Szczesnytendon/Bioreactor/LabVIEW code/Read me.docx

Please extract the zaber drivers into the folder before running the LabVIEW program.
