Szczesnytendon/Bioreactor/BOM Bioreactor.xlsx

Sheet: Basic BOM
 | Part | Company | Vendor (if different than company) | Serial number/model number/Link | Quanitity | Unit Price (Approximate) $ | Notes
Electrical
 | LVDT | TE connectivity | Digikey | HR 200 (https://www.digikey.com/en/products/detail/te-connectivity-measurement-specialties/02560391-000/3283570) | 4 | 192.8
 | LVDT conditioner | TE connectivity | Digikey | LVM 110 (https://www.digikey.com/en/products/detail/te-connectivity-measurement-specialties/04171776-000/373818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) | 4 | 223.4
 | AC to DC converter |  | Digikey | Link (https://www.digikey.com/en/products/detail/recom-power/RAC10-15DK-277/7807874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) | 1 | 10.8
 | Power cable |  | Digikey | Link (https://www.digikey.com/en/products/detail/qualtek/221002-01/245570) | 1 | 3.1
 | Load cell | Honeywell |  | Model 31, 10 lbs (https://sps.honeywell.com/us/en/products/sensing-and-iot/test-and-measurement-products/load-cells/miniature-load-cells/model-31-series) | 1 | 755
 | Load cell conditioner | Honeywell |  | Model GM Display Conditioner (https://sps.honeywell.com/us/en/products/sensing-and-iot/test-and-measurement-products/instrumentation/display-and-conditioning/gm-series) | 1 | 550
 | DAQ board | NI instruments |  | USB 6001 (https://www.ni.com/sic/configurator/configure.action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) | 1 | 220
 | Vertical Motor | Zaber |  | VSR40A-T3A (https://www.zaber.com/products/vertical-stages/VSR/details/VSR40A-T3A) | 1 | 1966
 | Motor Controller | Zaber |  | X-MCB1-KX13B (https://www.zaber.com/products/controllers-joysticks/X-MCB1/details/X-MCB1) | 1 | 720
Mechanical
 | T slot framing (20 mm) |  | McMaster Carr | 5537T101 (https://www.mcmaster.com/5537T101-5537T104/) | 6 | 8.28
 | T slot brackets |  | McMaster Carr | 5537T518 (https://www.mcmaster.com/5537T518/) | 16 | 5.04
 | 1 inch linear bearings | Tusk Direct |  | RX1-1SS | 4 | 210 | Call the company and ask for stainless steel interiors to prevent corrosion in humid environment of the incubator
 | 2 inch linear bearings | Tusk Direct |  | RX1-2SS | 4 | 229 | Call the company and ask for stainless steel interiors to prevent corrosion in humid environment of the incubator
 | Lube for bearings | Tusk Direct |  | LL-1 (https://www.tuskdirect.com/products/linear-lube.html) | 1 | 10
 | Pulleys |  | Amazon | PH0300SPL (https://www.amazon.com/gp/product/B00KZ0VYPU/ref=ppx_yo_dt_b_search_asin_title?ie=UTF8&psc=1) | 4 | 10.98
 | Hooks |  | McMaster Carr | 9491T11 (https://www.mcmaster.com/9491T11/) | 1 | 3.93
 | Fishing line |  | Amazon | Link (https://www.amazon.com/Stren-Fluorocast-Fluorocarbon-Fishing-Line/dp/B00NWD3LD0?th=1&psc=1) | 1 | 5.99
 | Weights |  | Amazon | PHZNW100SET (https://www.amazon.com/gp/product/B01LFTMBAG/ref=ppx_yo_dt_b_search_asin_title?ie=UTF8&psc=1) | 4 | 12.96
Fasteners
 | 1/4-20 socket screws (1-1/4"") |  | McMaster Carr | 92185A544 (https://www.mcmaster.com/92185A544/) | 1 | 3.75
 | 8-32 socket screws (7/8") |  | McMaster Carr | 92185A198 (https://www.mcmaster.com/92185A198/) | 1 | 8.61
 | 6- 32 threaded rod (3/4") |  | McMaster Carr | 90575A162 (https://www.mcmaster.com/90575A162/) | 1 | 9.18
 | 6- 32 threaded rod (1-1/2") |  | McMaster Carr | 90575A164 (https://www.mcmaster.com/90575A164/) | 1 | 6.81
 | 6-32 nuts |  | McMaster Carr | 90730A007 (https://www.mcmaster.com/90730A007/) | 1 | 4.04
 | 6-32 socket screws (3/4") |  | McMaster Carr | 92185A151 (https://www.mcmaster.com/92185A151/) | 1 | 2.95
 | 2-56 socket screws (7/16") |  | McMaster Carr | 92185A081 (https://www.mcmaster.com/92185A081/) | 1 | 4.02
 | 2-56 socket screws (9/16") |  | McMaster Carr | 92185A086 (https://www.mcmaster.com/92185A086/) | 1 | 4.46
 | 2-56 socket screws (5/16") |  | McMaster Carr | 92185A078 (https://www.mcmaster.com/92185A078/) | 1 | 3.84
 | 2-56 socket screws (1- 3/8") |  | McMaster Carr | 92196A090 (https://www.mcmaster.com/92196A090/) | 1 | 11.12
Miscelleaneous
 | V cutter |  | McMaster Carr | 29755A17 (https://www.mcmaster.com/29755A17/) | 1 | 51.55 | If not available in the machining shop
 | Sandpaper |  | McMaster Carr | 4671A32 (https://www.mcmaster.com/catalog/127/2848) | As required | 18.49
 | 4 Well plates |  | Thermo Fisher | 267061 (https://www.thermofisher.com/order/catalog/product/267060?SID=srch-srp-267060) | As required | 484

Sheet: Minimum costs + materials
Part |  |  | Link | Qty | Unit Cost | Total cost
Vertical Motor | Zaber |  | VSR40A-T3A (https://www.zaber.com/products/vertical-stages/VSR/details/VSR40A-T3A) | 1 | 1966 | 1966
Motor Controller | Zaber |  | X-MCB1-KX13B (https://www.zaber.com/products/controllers-joysticks/X-MCB1/details/X-MCB1) | 1 | 720 | 720
1 inch linear bearings | Tusk Direct |  | RX1-1SS | 4 | 210 | 840
2 inch linear bearings | Tusk Direct |  | RX1-2SS | 4 | 229 | 916
Pulleys |  | Amazon | PH0300SPL (https://www.amazon.com/gp/product/B00KZ0VYPU/ref=ppx_yo_dt_b_search_asin_title?ie=UTF8&psc=1) | 4 | 10.98 | 43.92
T slot framing (20 mm) |  | McMaster Carr | 5537T101 (https://www.mcmaster.com/5537T101-5537T104/) | 6 | 8.28 | 49.68
T slot brackets |  | McMaster Carr | 5537T518 (https://www.mcmaster.com/5537T518/) | 16 | 5.04 | 80.64
Polycarbonate (Base plate) |  | McMaster Carr | 84805K32 (https://www.mcmaster.com/84805K32) | 1 | 209.85 | 209.85
Aluminum (Back plate) |  | McMaster Carr | 8975K215 (https://www.mcmaster.com/8975K215) | 1 | 22.95 | 22.95
Grip and grip holders |  |  | 9083K46 (https://www.mcmaster.com/9083K46) | 1 | 117.81 | 117.81
Load cell placeholder |  |  | 8974K28 (https://www.mcmaster.com/8974K28) | 1 | 1.97 | 1.97
Polycarbonate (blocks under grips) |  |  | 1749K549 (https://www.mcmaster.com/1749K549) | 1 | 20.38 | 20.38
Pulley base |  |  | 9008K46 (https://www.mcmaster.com/9008K46) | 1 | 20.98 | 20.98
 |  |  |  |  |  | 5010.18

Sheet: Our costs
Machining costs |  |  |  |  |  | 4275
Vertical Motor | Zaber |  | VSR40A-T3A (https://www.zaber.com/products/vertical-stages/VSR/details/VSR40A-T3A) | 1 | 1966 | 1966
Motor Controller | Zaber |  | X-MCB1-KX13B (https://www.zaber.com/products/controllers-joysticks/X-MCB1/details/X-MCB1) | 1 | 720 | 720
1 inch linear bearings | Tusk Direct |  | RX1-1SS | 4 | 210 | 840
2 inch linear bearings | Tusk Direct |  | RX1-2SS | 4 | 229 | 916
Pulleys |  | Amazon | PH0300SPL (https://www.amazon.com/gp/product/B00KZ0VYPU/ref=ppx_yo_dt_b_search_asin_title?ie=UTF8&psc=1) | 4 | 10.98 | 43.92
T slot framing (20 mm) |  | McMaster Carr | 5537T101 (https://www.mcmaster.com/5537T101-5537T104/) | 6 | 8.28 | 49.68
T slot brackets |  | McMaster Carr | 5537T518 (https://www.mcmaster.com/5537T518/) | 16 | 5.04 | 80.64
LVDT | TE connectivity | Digikey | HR 200 (https://www.digikey.com/en/products/detail/te-connectivity-measurement-specialties/02560391-000/3283570) | 4 | 192.8 | 771.2
LVDT conditioner | TE connectivity | Digikey | LVM 110 (https://www.digikey.com/en/products/detail/te-connectivity-measurement-specialties/04171776-000/373818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) | 4 | 223.4 | 893.6
AC to DC converter |  | Digikey | Link (https://www.digikey.com/en/products/detail/recom-power/RAC10-15DK-277/7807874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) | 1 | 10.8 | 10.8
Power cable |  | Digikey | Link (https://www.digikey.com/en/products/detail/qualtek/221002-01/245570) | 1 | 3.1 | 3.1
Load cell | Honeywell |  | Model 31, 10 lbs (https://sps.honeywell.com/us/en/products/sensing-and-iot/test-and-measurement-products/load-cells/miniature-load-cells/model-31-series) | 1 | 755 | 755
Load cell conditioner | Honeywell |  | Model GM Display Conditioner (https://sps.honeywell.com/us/en/products/sensing-and-iot/test-and-measurement-products/instrumentation/display-and-conditioning/gm-series) | 1 | 550 | 550
DAQ board | NI instruments |  | USB 6001 (https://www.ni.com/sic/configurator/configure.action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) | 1 | 220 | 220
 |  |  |  |  |  | 12094.94
