Szczesnytendon/Bioreactor/Bioreactor design/Grips/Flat Grip Assem.SLDASM

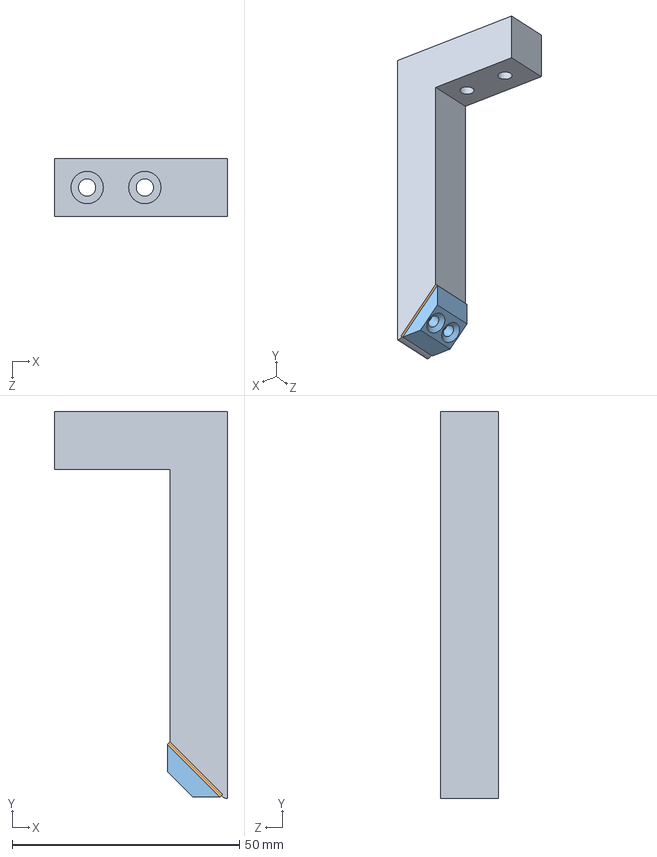
[picture p1: CAD file, 2021-02-22]
Bioreactor design/Grips/Flat Grip Assem.SLDASM
38.1 x 85.1 x 12.7 mm
Flat Grip
Spacer x 2
Flat Grip Clamp
