Szczesnytendon/Bioreactor/Bioreactor design/Motor subassembly.SLDASM

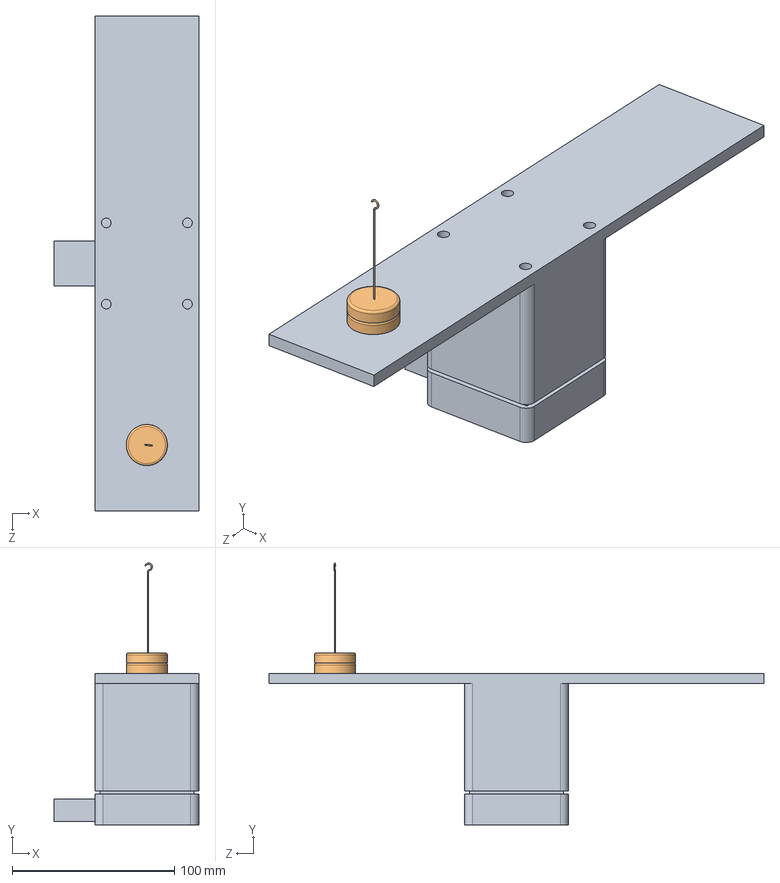
[picture p2: CAD file, 2021-02-22]
Bioreactor design/Motor subassembly.SLDASM
89.1 x 161.3 x 304.8 mm
Motor
Weights
