Szczesnytendon/Bioreactor/Bioreactor design/Fixed grip subassembly.SLDASM

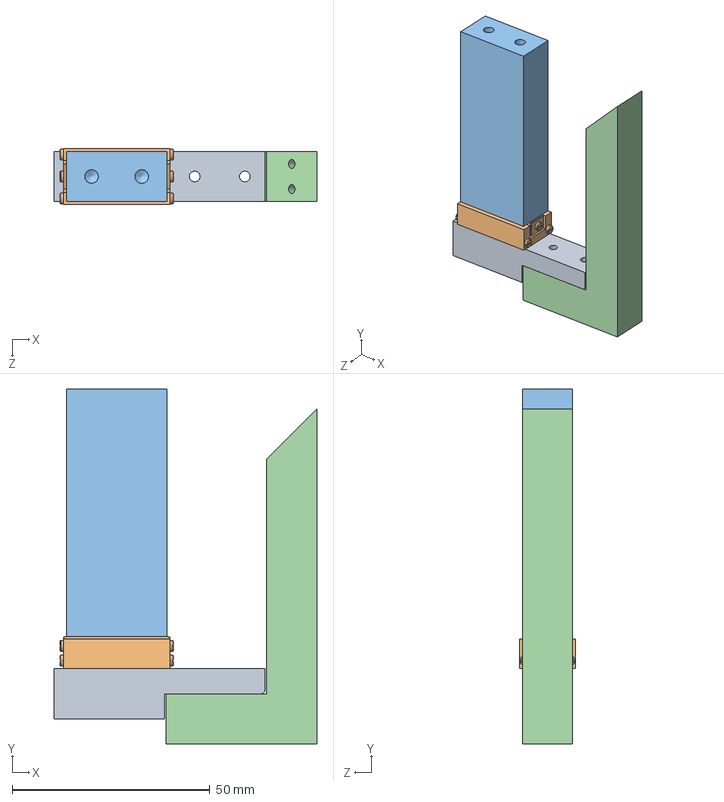
[picture p3: CAD file, 2021-02-22]
Bioreactor design/Fixed grip subassembly.SLDASM
66.5 x 89.8 x 14.2 mm
Fixed Grip holder
Fixed Linear bearing
Plastic block under the fixed grip
Stainless steel grip
