Szczesnytendon/Bioreactor/Bioreactor design/Bioreactor Assembly.SLDASM

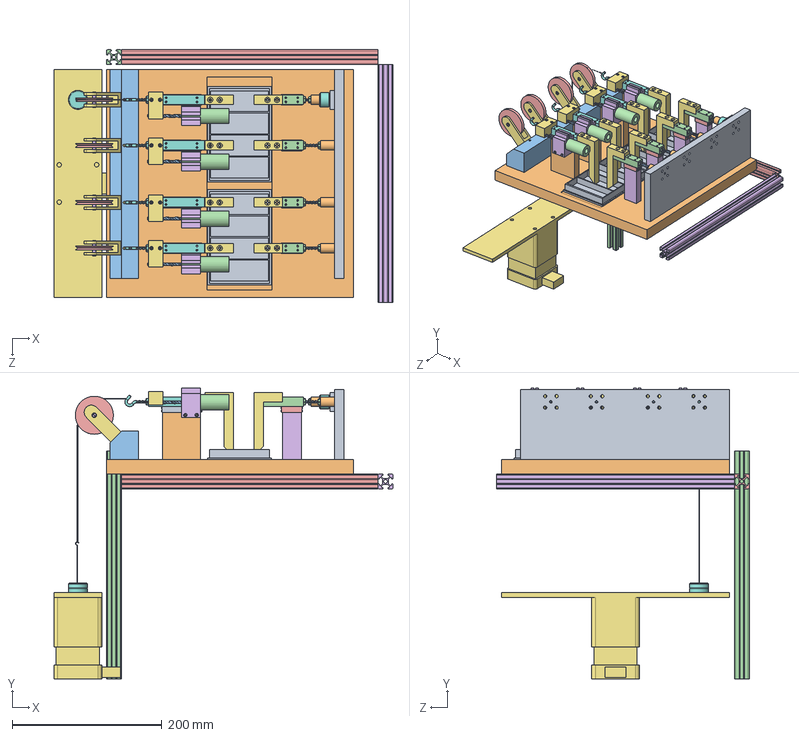
[picture p4: CAD file, 2021-02-22]
Bioreactor design/Bioreactor Assembly.SLDASM
453.0 x 388.8 x 337.5 mm
Back plate
Base plate
Pulley base
Fixed Grip holder x 4
Fixed Linear bearing x 4
Plastic block under the fixed grip x 4
Stainless steel grip x 8
Movable grip holder x 4
Movable linear bearing x 4
Plastic block under the movable grip x 4
Core connecting rod x 4
LVDT body x 4
LVDT core x 4
LVDT mount x 4
Core mount x 4
Hook x 4
Well plate x 2
Load cell substitute x 3
6-32 Threaded rod 1.5in x 3
6-32 Nut x 8
Pulley x 4
Pulley screws x 8
Pulley support plastic x 4
Load cell
Load cell plate
Load cell thread adapter
6-32 threaded rod 0.75inch
Motor
Weights
rope try
