Szczesnytendon/Bioreactor/Bioreactor design/Load cell substitute subassembly.SLDASM

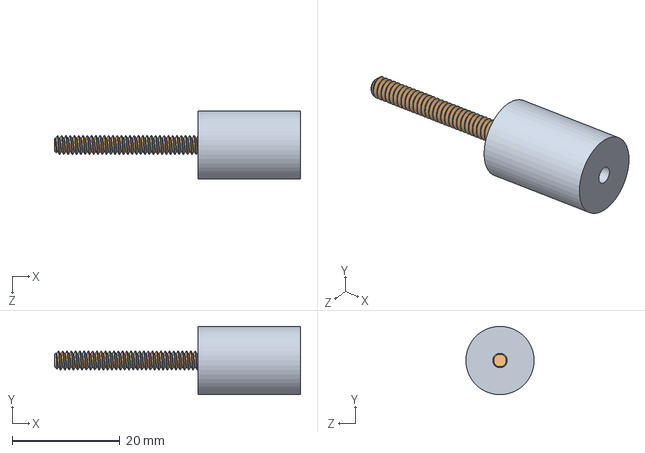
[picture p5: CAD file, 2021-02-22]
Bioreactor design/Load cell substitute subassembly.SLDASM
45.7 x 12.7 x 12.7 mm
Load cell substitute
6-32 Threaded rod 1.5in
