Szczesnytendon/Bioreactor/Bioreactor design/Stand subassembly.SLDASM

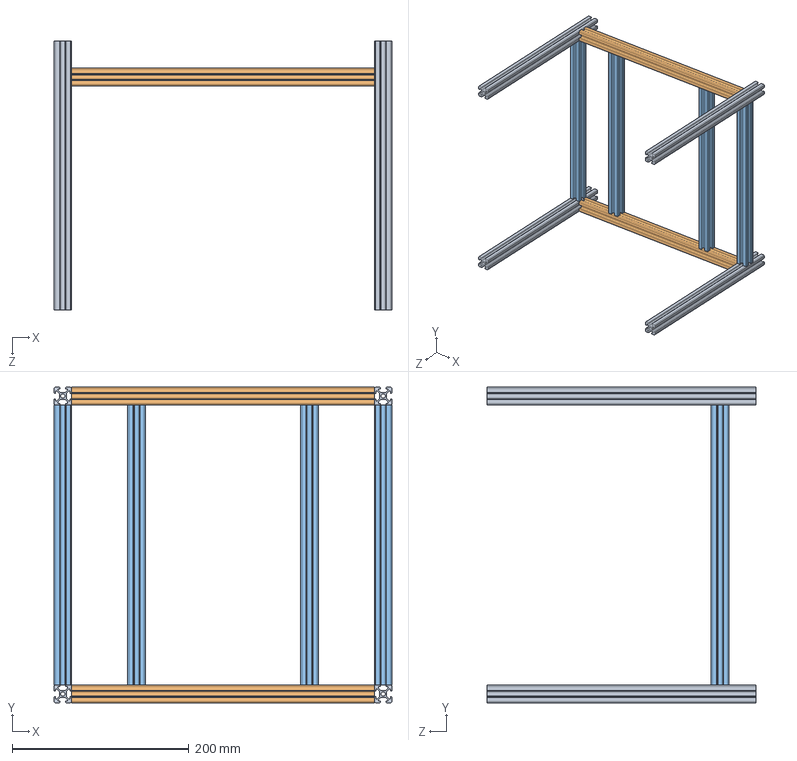
[picture p6: CAD file, 2021-02-22]
Bioreactor design/Stand subassembly.SLDASM
382.9 x 357.5 x 304.8 mm
Aluminum 20mm t slot 12 in vertical x 4
Aluminum 20mm t slot 13.5in x 2
Aluminum 20mm t slot 12.5in x 4
