Szczesnytendon/Bioreactor/Bioreactor design/Pulley subassembly.SLDASM

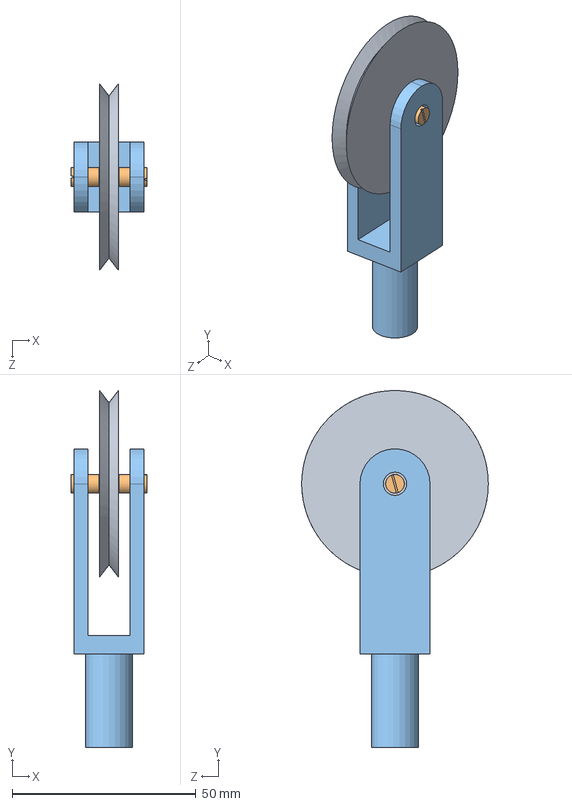
[picture p7: CAD file, 2021-02-22]
Bioreactor design/Pulley subassembly.SLDASM
20.6 x 97.1 x 50.8 mm
Pulley
Pulley screws x 2
Pulley support plastic
