Szczesnytendon/Bioreactor/Bioreactor design/Load cell subassembly.SLDASM

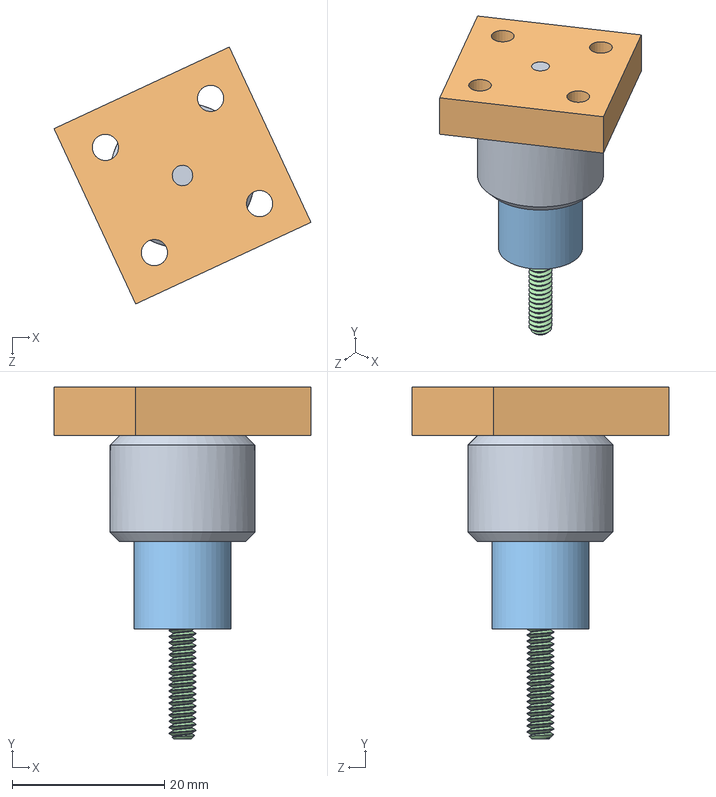
[picture p8: CAD file, 2021-02-22]
Bioreactor design/Load cell subassembly.SLDASM
33.8 x 46.2 x 33.8 mm
Load cell
Load cell plate
Load cell thread adapter
6-32 threaded rod 0.75inch
