Szczesnytendon/Bioreactor/Bioreactor design/Core connecting rod.SLDPRT

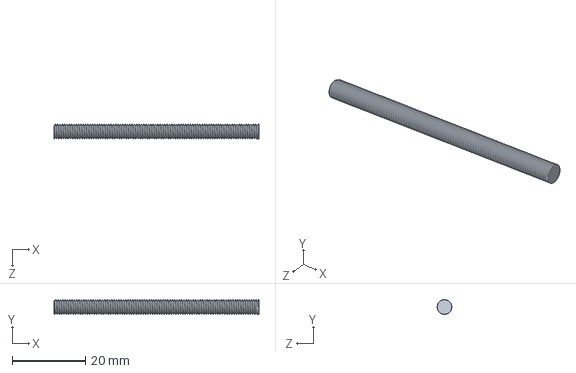
[picture p9: CAD file, 2021-02-22]
Bioreactor design/Core connecting rod.SLDPRT
55.9 x 4.00 x 4.00 mm
