Szczesnytendon/Bioreactor/Bioreactor design/Grips/Serrated grip left.SLDPRT

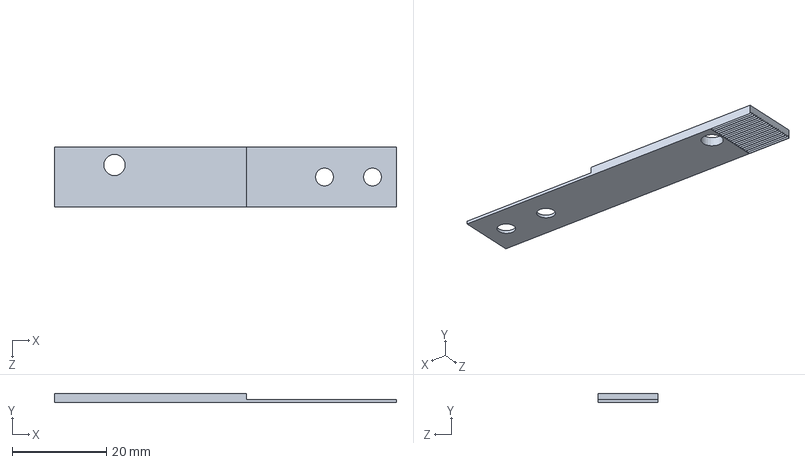
[picture p10: CAD file, 2021-02-22]
Bioreactor design/Grips/Serrated grip left.SLDPRT
72.4 x 1.90 x 12.7 mm
