Szczesnytendon/Bioreactor/Bioreactor design/Stainless steel grip.SLDPRT

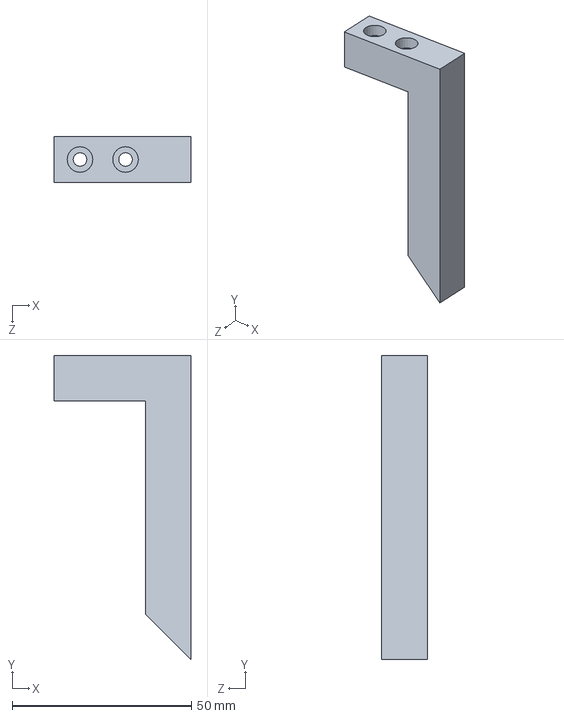
[picture p11: CAD file, 2021-02-22]
Bioreactor design/Stainless steel grip.SLDPRT
38.1 x 84.8 x 12.7 mm
