Szczesnytendon/Bioreactor/Bioreactor design/Core mount.SLDPRT

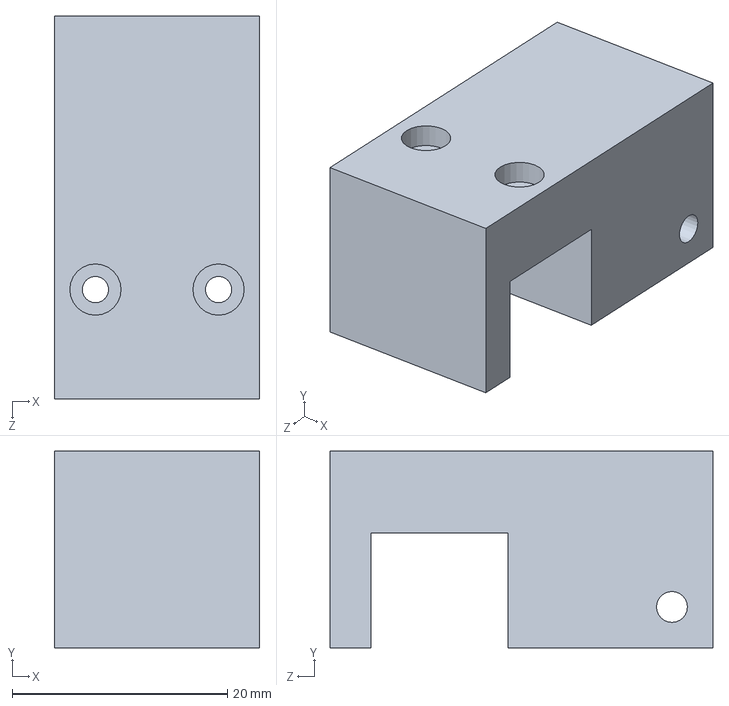
[picture p12: CAD file, 2021-02-22]
Bioreactor design/Core mount.SLDPRT
19.1 x 18.3 x 35.6 mm
