Szczesnytendon/Bioreactor/Bioreactor design/Grips/Spacer.SLDPRT

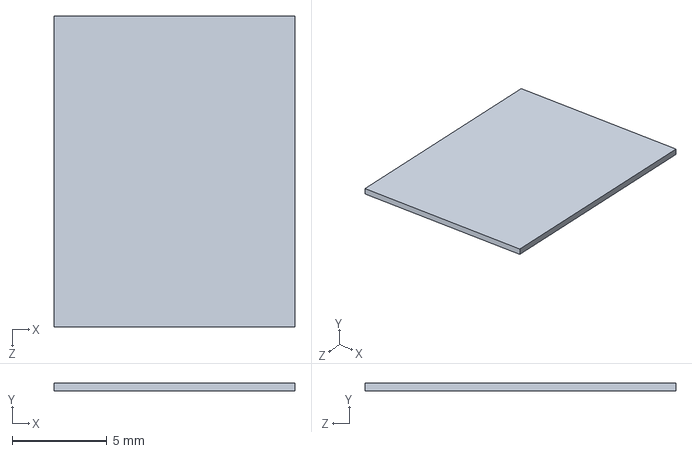
[picture p13: CAD file, 2021-02-22]
Bioreactor design/Grips/Spacer.SLDPRT
12.7 x 0.4 x 16.4 mm
