Szczesnytendon/Bioreactor/Bioreactor design/Fixed Linear bearing.SLDPRT

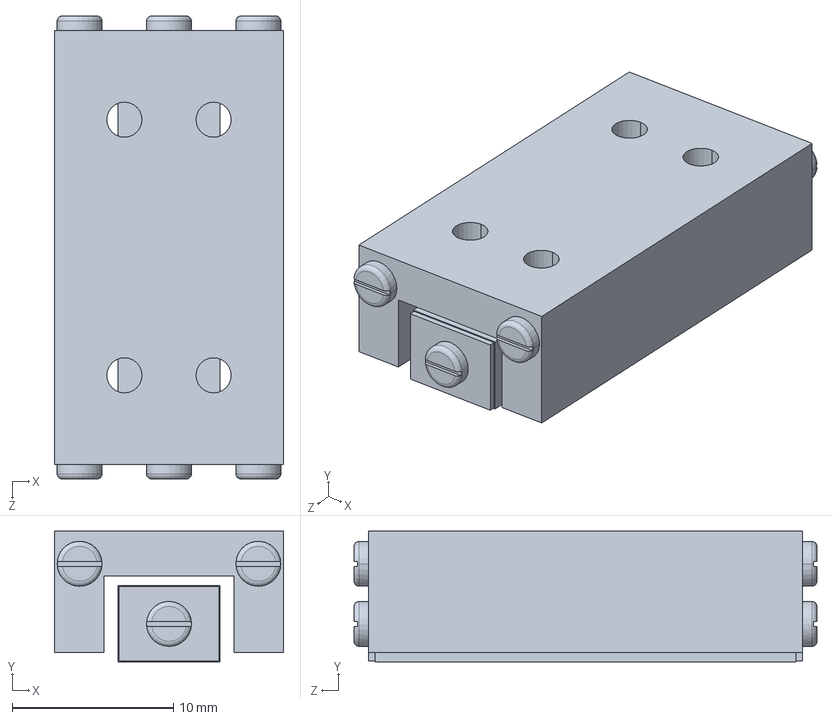
[picture p14: CAD file, 2021-02-22]
Bioreactor design/Fixed Linear bearing.SLDPRT
14.2 x 8.13 x 28.8 mm
