Szczesnytendon/Bioreactor/Bioreactor design/Grips/Serrated grip holder.SLDPRT

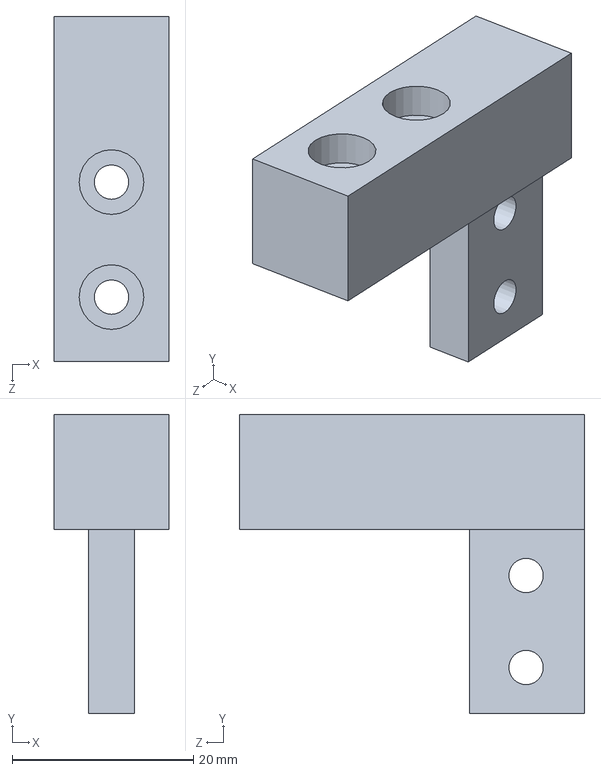
[picture p15: CAD file, 2021-02-22]
Bioreactor design/Grips/Serrated grip holder.SLDPRT
12.7 x 33.0 x 38.1 mm
