Szczesnytendon/Bioreactor/Bioreactor design/Motor.SLDPRT

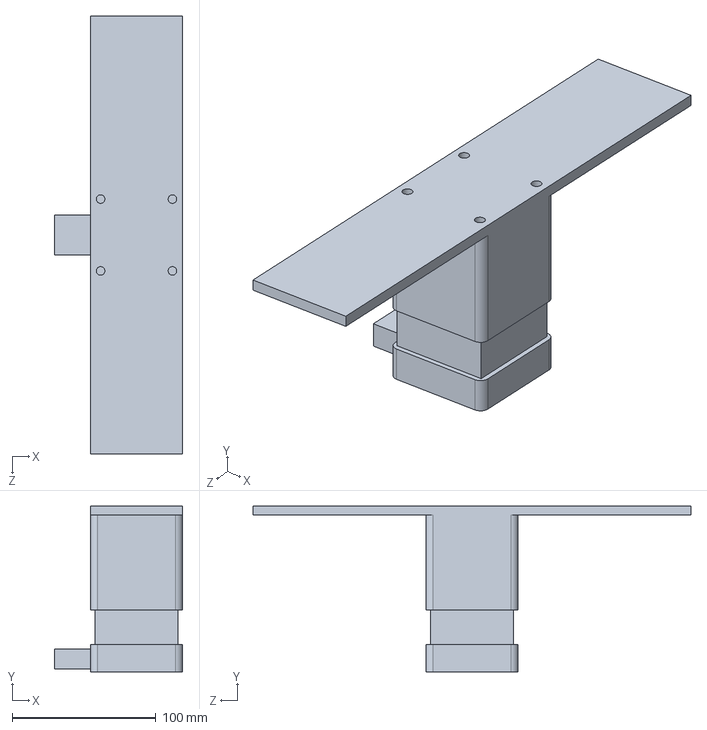
[picture p16: CAD file, 2021-02-22]
Bioreactor design/Motor.SLDPRT
89.1 x 115.3 x 304.8 mm
