Szczesnytendon/Bioreactor/Bioreactor design/Fixed Grip holder.SLDPRT

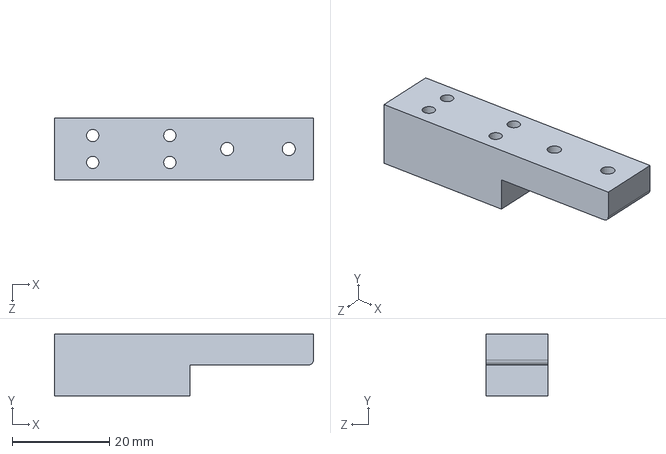
[picture p17: CAD file, 2021-02-22]
Bioreactor design/Fixed Grip holder.SLDPRT
53.3 x 12.7 x 12.7 mm
