Szczesnytendon/Bioreactor/Bioreactor design/Grips/Flat Grip Clamp.SLDPRT

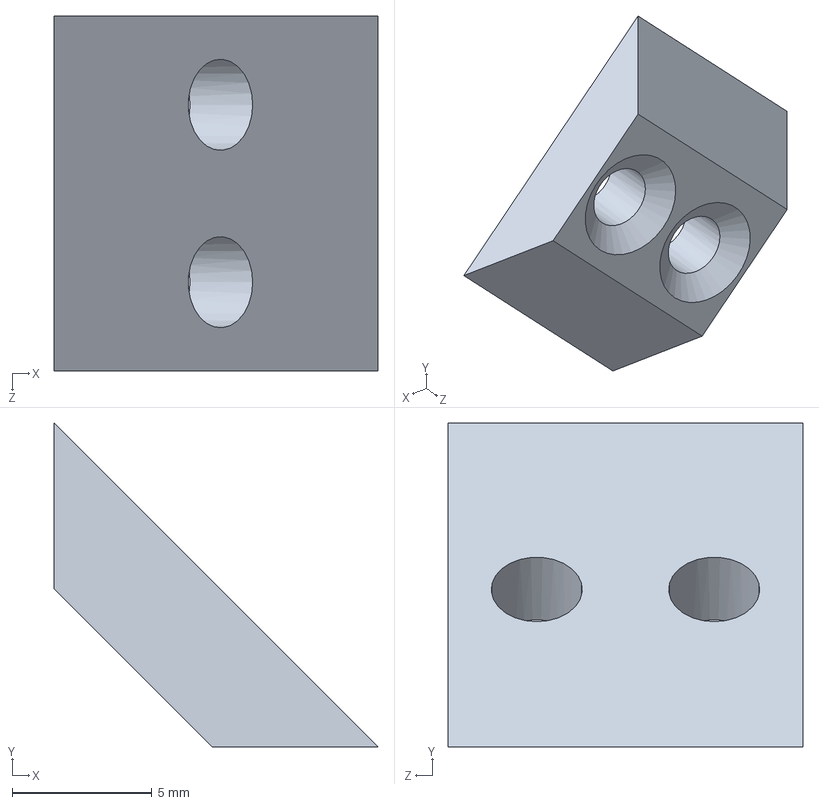
[picture p18: CAD file, 2021-02-22]
Bioreactor design/Grips/Flat Grip Clamp.SLDPRT
11.6 x 11.6 x 12.7 mm
