Szczesnytendon/Bioreactor/Bioreactor design/Movable linear bearing.SLDPRT

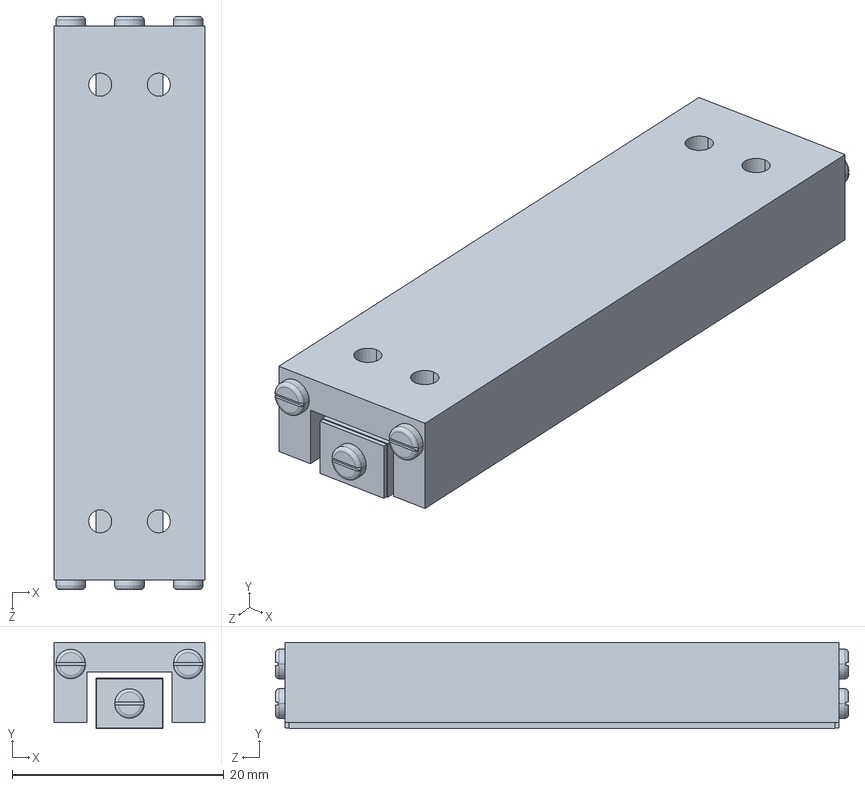
[picture p19: CAD file, 2021-02-22]
Bioreactor design/Movable linear bearing.SLDPRT
14.2 x 8.13 x 54.2 mm
