Szczesnytendon/Bioreactor/Bioreactor design/Pulley base.SLDPRT

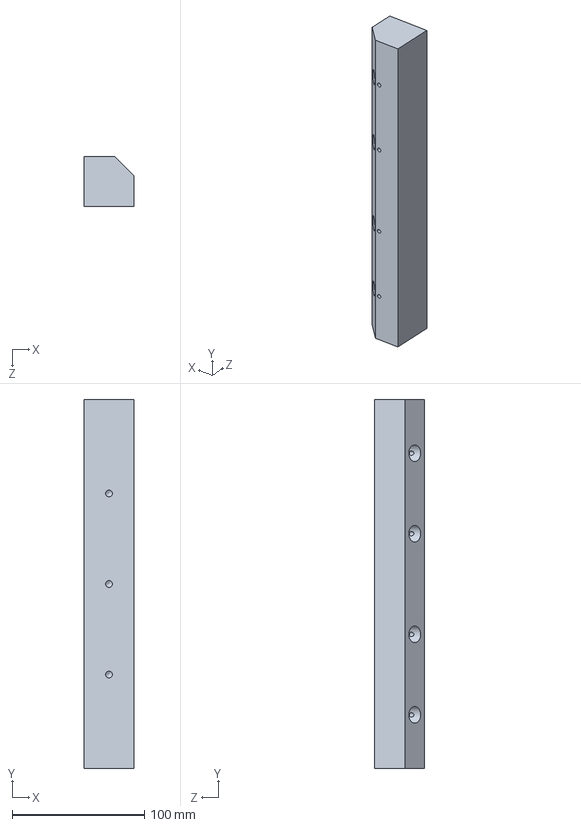
[picture p20: CAD file, 2021-02-22]
Bioreactor design/Pulley base.SLDPRT
38.1 x 279.4 x 38.1 mm
