Szczesnytendon/Bioreactor/Bioreactor design/Aluminum 20mm t slot 13.5in.SLDPRT

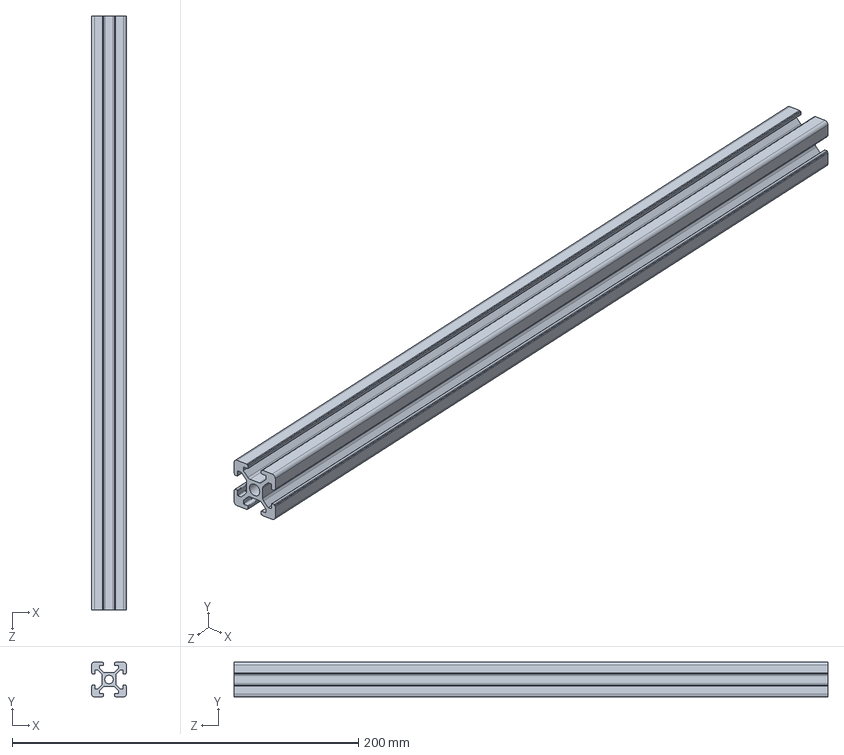
[picture p21: CAD file, 2021-02-22]
Bioreactor design/Aluminum 20mm t slot 13.5in.SLDPRT
20.0 x 20.0 x 342.9 mm
