Szczesnytendon/Bioreactor/Bioreactor design/Weights.SLDPRT

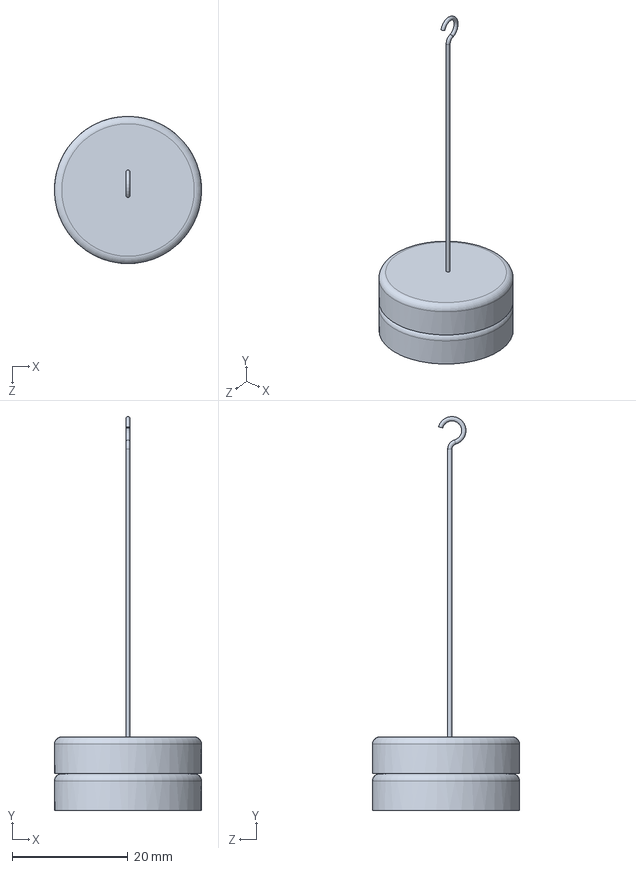
[picture p22: CAD file, 2021-02-22]
Bioreactor design/Weights.SLDPRT
25.4 x 68.0 x 25.4 mm
