Szczesnytendon/Bioreactor/Bioreactor design/Load cell substitute.SLDPRT

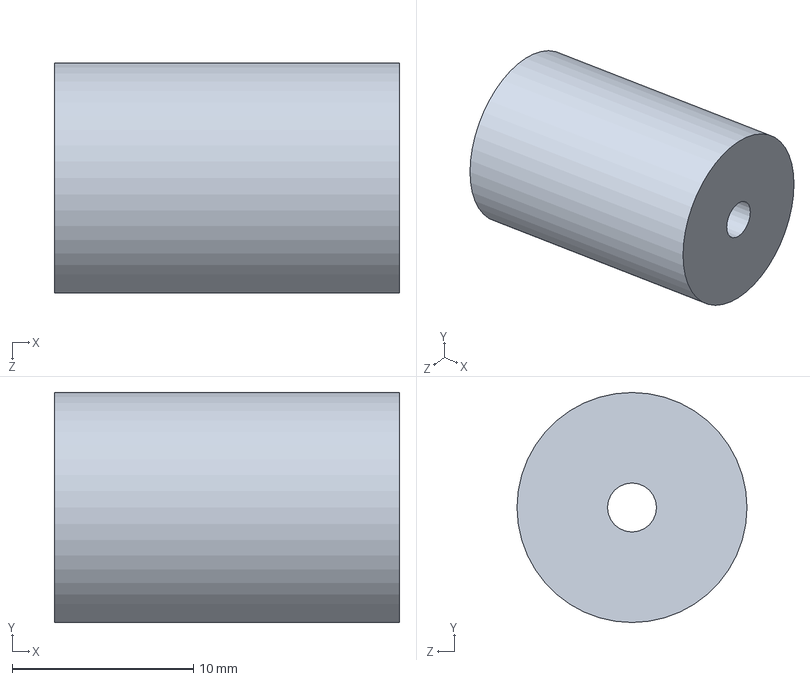
[picture p23: CAD file, 2021-02-22]
Bioreactor design/Load cell substitute.SLDPRT
19.1 x 12.7 x 12.7 mm
