Szczesnytendon/Bioreactor/Bioreactor design/Base plate.SLDPRT

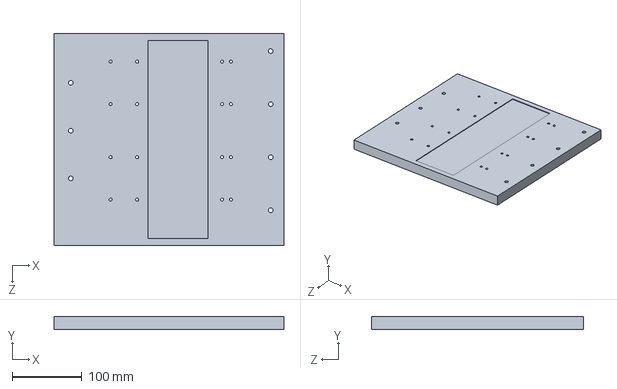
[picture p24: CAD file, 2021-02-22]
Bioreactor design/Base plate.SLDPRT
330.2 x 19.1 x 304.8 mm
