Szczesnytendon/Bioreactor/Bioreactor design/Plastic block under the movable grip.SLDPRT

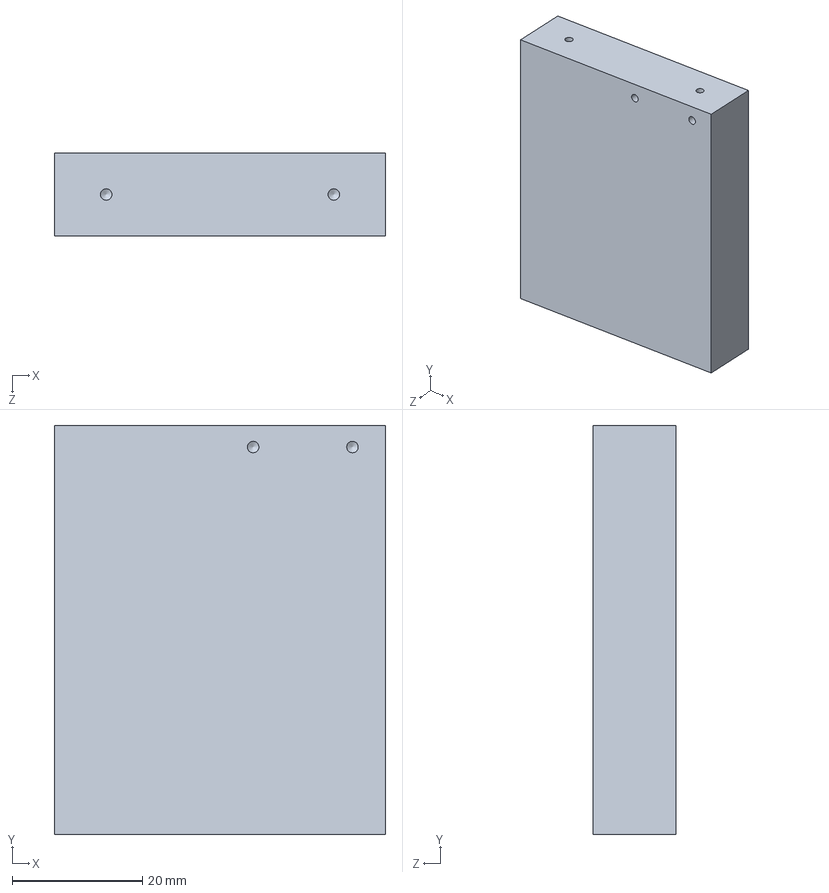
[picture p25: CAD file, 2021-02-22]
Bioreactor design/Plastic block under the movable grip.SLDPRT
50.8 x 62.7 x 12.7 mm
