Szczesnytendon/Bioreactor/Bioreactor design/LVDT core.SLDPRT

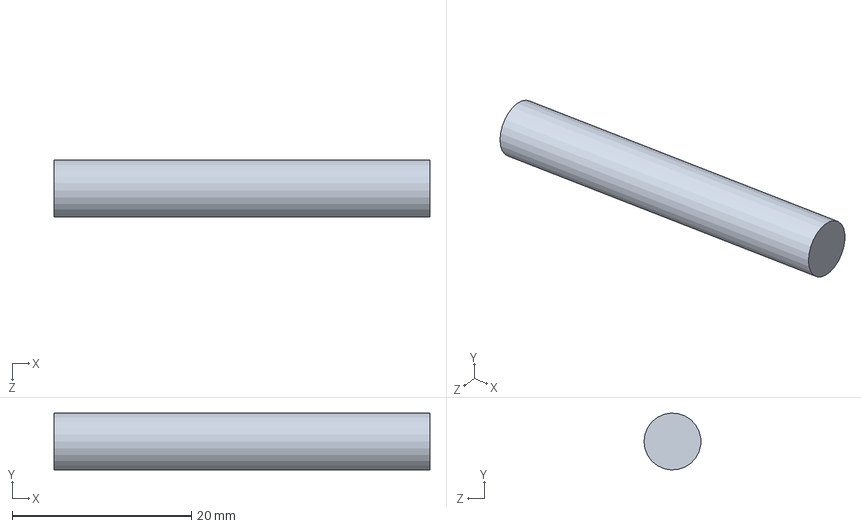
[picture p26: CAD file, 2021-02-22]
Bioreactor design/LVDT core.SLDPRT
41.9 x 6.34 x 6.35 mm
