Szczesnytendon/Bioreactor/Bioreactor design/Load cell plate.SLDPRT

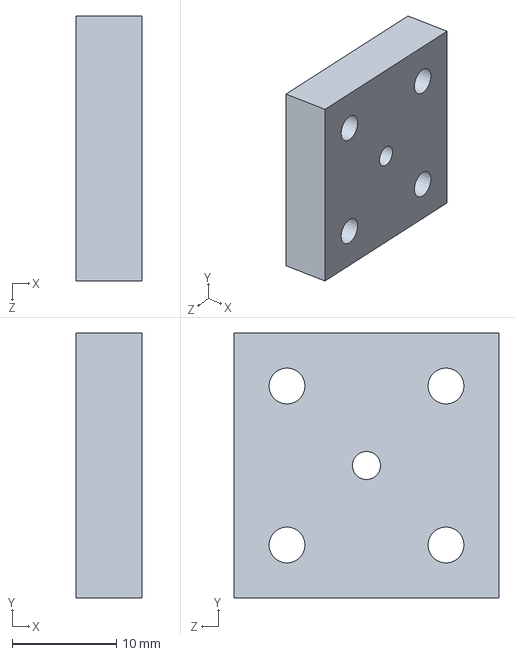
[picture p27: CAD file, 2021-02-22]
Bioreactor design/Load cell plate.SLDPRT
6.35 x 25.4 x 25.4 mm
