Szczesnytendon/Bioreactor/Bioreactor design/Aluminum 20mm t slot 12 in vertical.SLDPRT

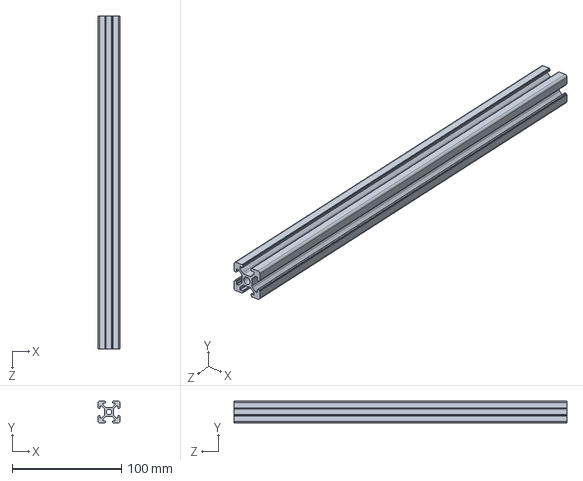
[picture p28: CAD file, 2021-02-22]
Bioreactor design/Aluminum 20mm t slot 12 in vertical.SLDPRT
20.0 x 20.0 x 304.8 mm
