Szczesnytendon/Bioreactor/Bioreactor design/6-32 Threaded rod 1.5in.SLDPRT

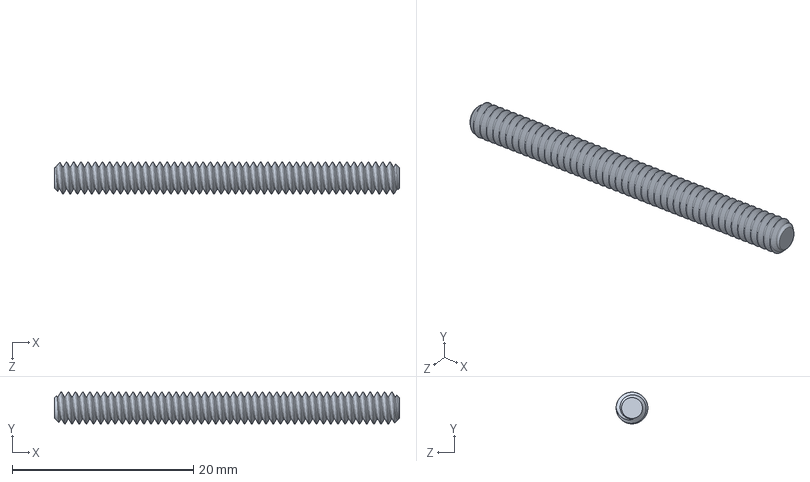
[picture p29: CAD file, 2021-02-22]
Bioreactor design/6-32 Threaded rod 1.5in.SLDPRT
38.1 x 3.51 x 3.51 mm
