Szczesnytendon/Bioreactor/Bioreactor design/Right threaded stud.SLDPRT

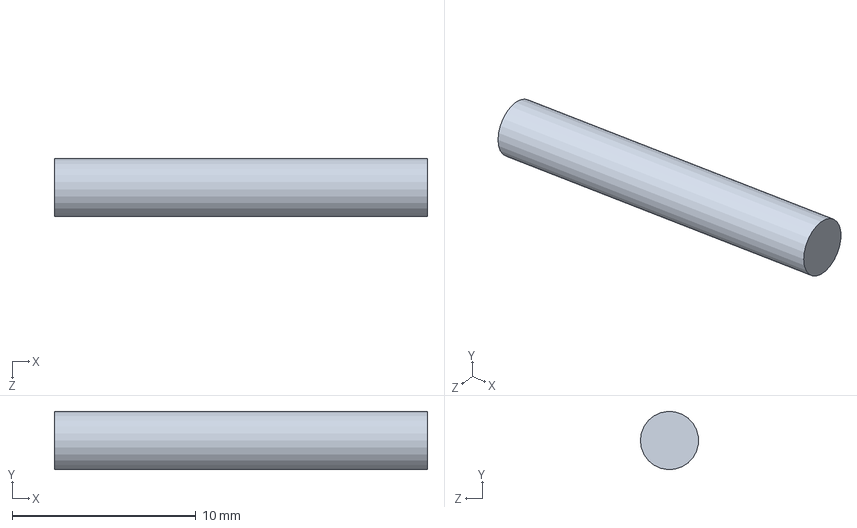
[picture p30: CAD file, 2021-02-22]
Bioreactor design/Right threaded stud.SLDPRT
20.3 x 3.17 x 3.17 mm
