Szczesnytendon/Bioreactor/Bioreactor design/LVDT mount.SLDPRT

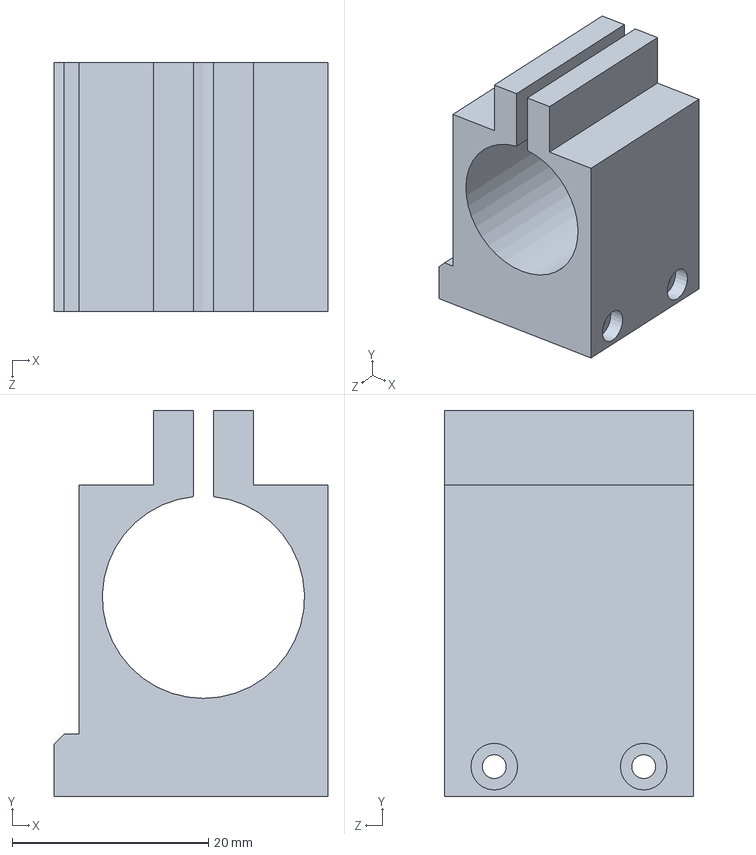
[picture p31: CAD file, 2021-02-22]
Bioreactor design/LVDT mount.SLDPRT
27.9 x 39.4 x 25.4 mm
