Szczesnytendon/Bioreactor/Bioreactor design/Load cell.SLDPRT

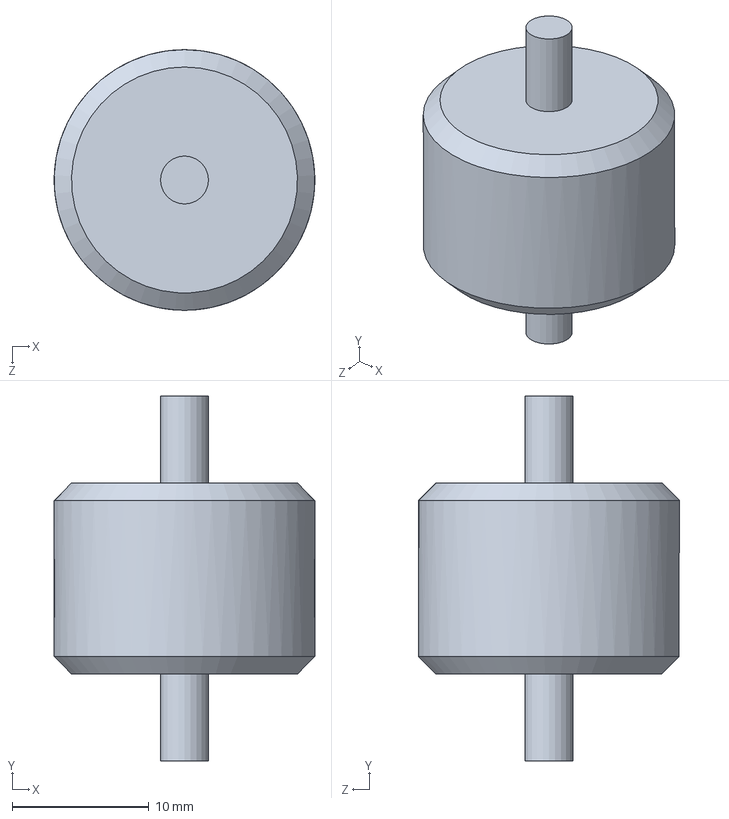
[picture p32: CAD file, 2021-02-22]
Bioreactor design/Load cell.SLDPRT
19.0 x 26.7 x 19.1 mm
