Szczesnytendon/Bioreactor/Bioreactor design/Back plate.SLDPRT

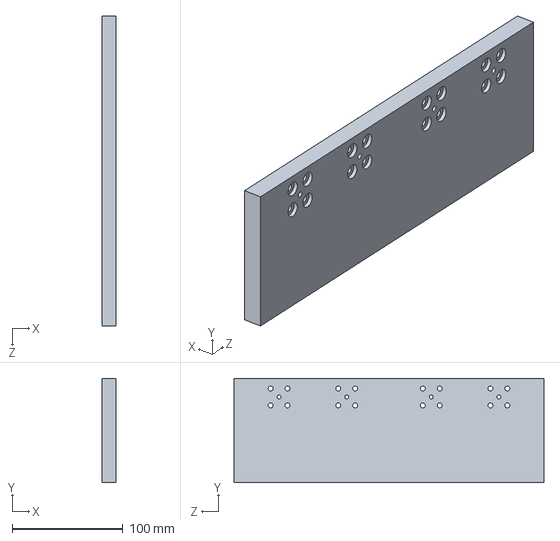
[picture p33: CAD file, 2021-02-22]
Bioreactor design/Back plate.SLDPRT
12.7 x 94.0 x 279.4 mm
