Szczesnytendon/Bioreactor/Bioreactor design/Aluminum 20mm t slot.SLDPRT

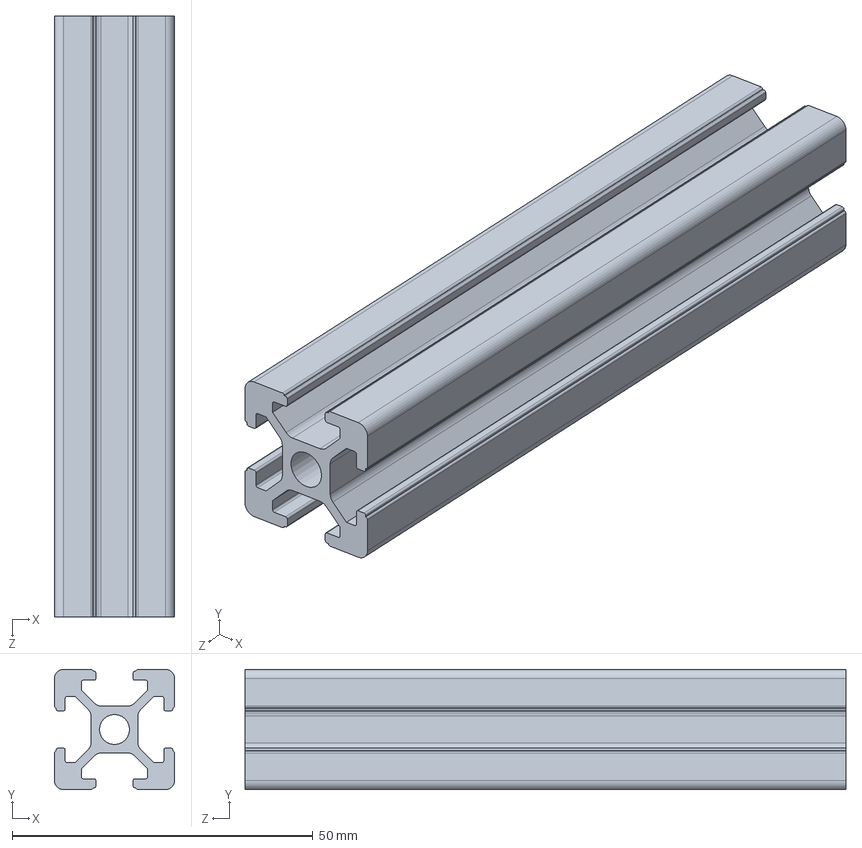
[picture p34: CAD file, 2021-02-22]
Bioreactor design/Aluminum 20mm t slot.SLDPRT
20.0 x 20.0 x 100.0 mm
