Szczesnytendon/Bioreactor/Bioreactor design/Pulley support plastic.SLDPRT

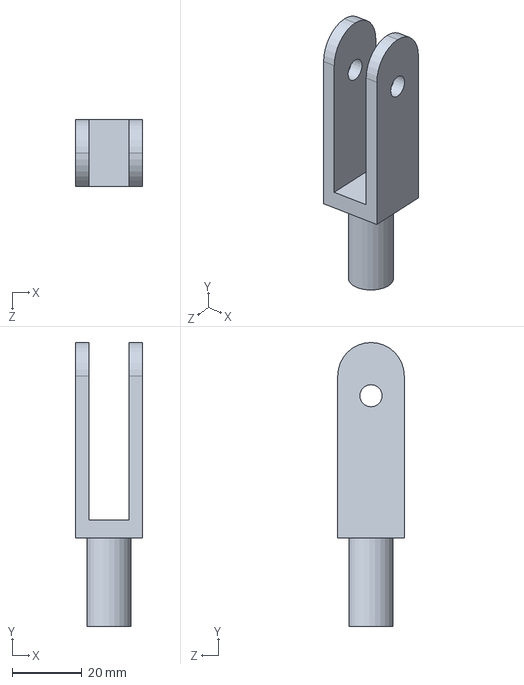
[picture p35: CAD file, 2021-02-22]
Bioreactor design/Pulley support plastic.SLDPRT
19.1 x 81.3 x 19.1 mm
