Szczesnytendon/Bioreactor/Bioreactor design/LVDT body.SLDPRT

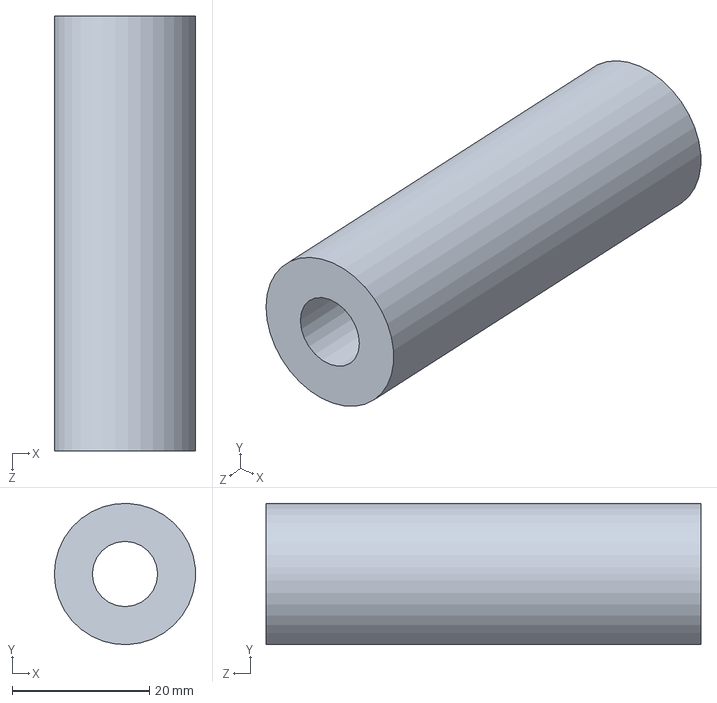
[picture p36: CAD file, 2021-02-22]
Bioreactor design/LVDT body.SLDPRT
20.6 x 20.6 x 63.5 mm
