Szczesnytendon/Bioreactor/Bioreactor design/Plastic block under the fixed grip.SLDPRT

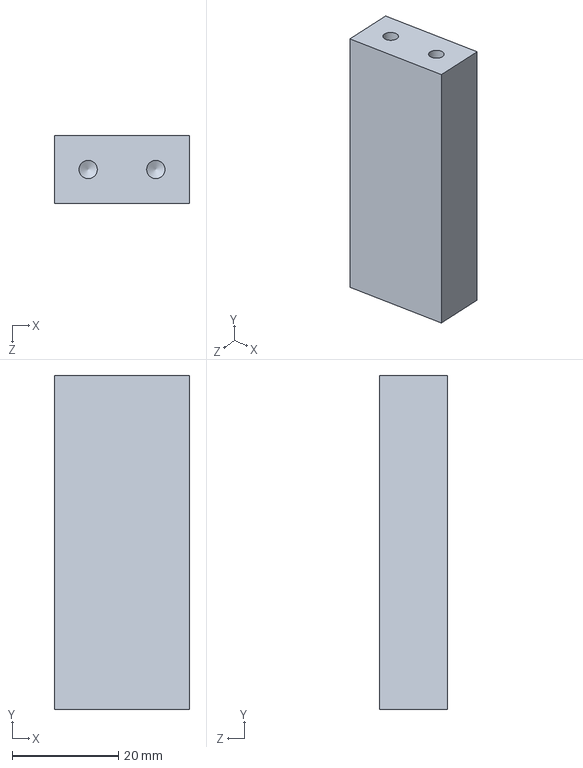
[picture p37: CAD file, 2021-02-22]
Bioreactor design/Plastic block under the fixed grip.SLDPRT
25.4 x 62.7 x 12.7 mm
