Szczesnytendon/Bioreactor/Bioreactor design/Hook.SLDPRT

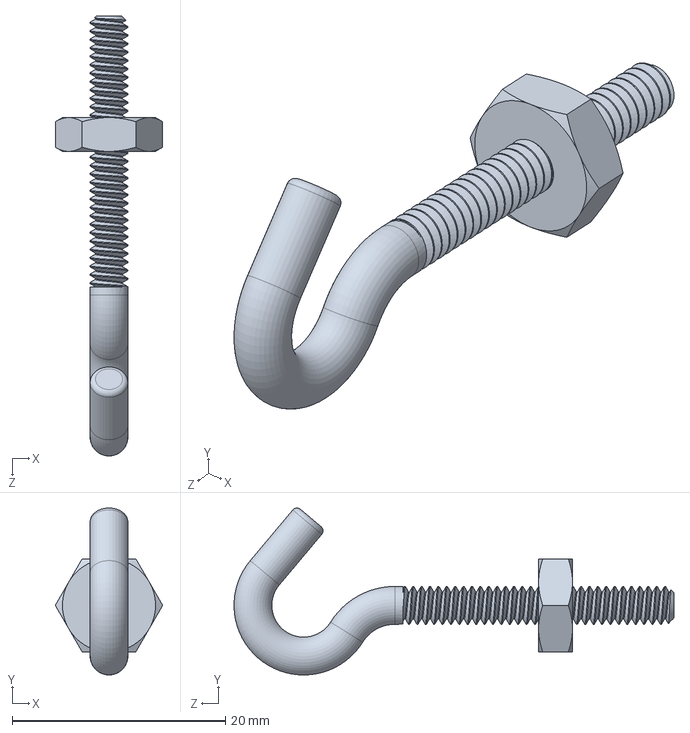
[picture p38: CAD file, 2021-02-22]
Bioreactor design/Hook.SLDPRT
10.1 x 15.7 x 41.3 mm
