Szczesnytendon/Bioreactor/Bioreactor design/Well plate.SLDPRT

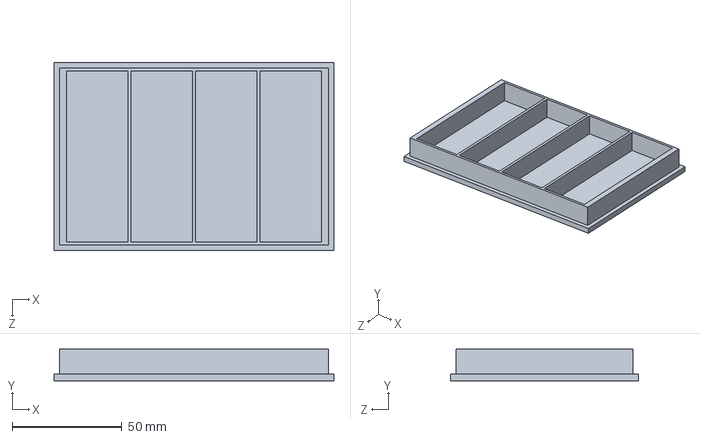
[picture p39: CAD file, 2021-02-22]
Bioreactor design/Well plate.SLDPRT
127.8 x 14.5 x 85.6 mm
