Szczesnytendon/Bioreactor/Bioreactor design/rope try.SLDPRT

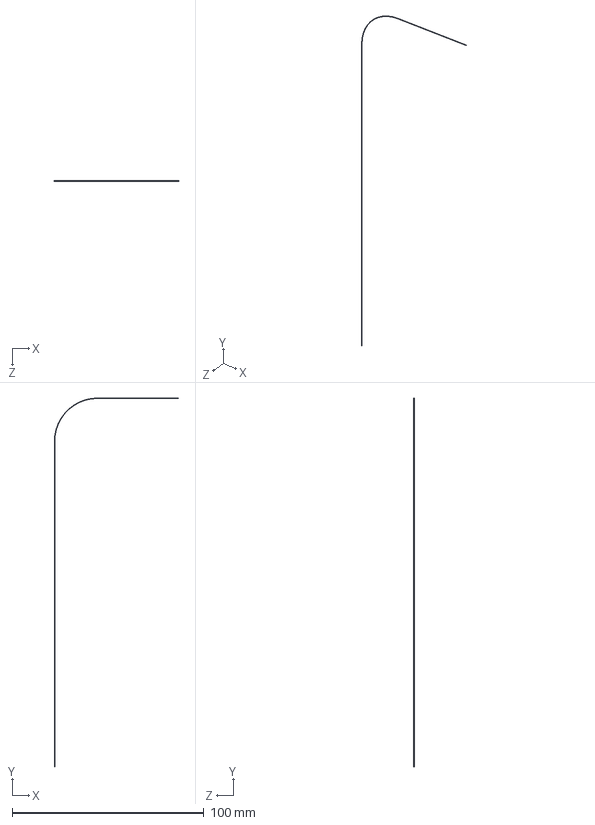
[picture p40: CAD file, 2021-02-22]
Bioreactor design/rope try.SLDPRT
64.8 x 192.3 x 0.254 mm
