Szczesnytendon/Bioreactor/Bioreactor design/Aluminum 20mm t slot 12.5in.SLDPRT

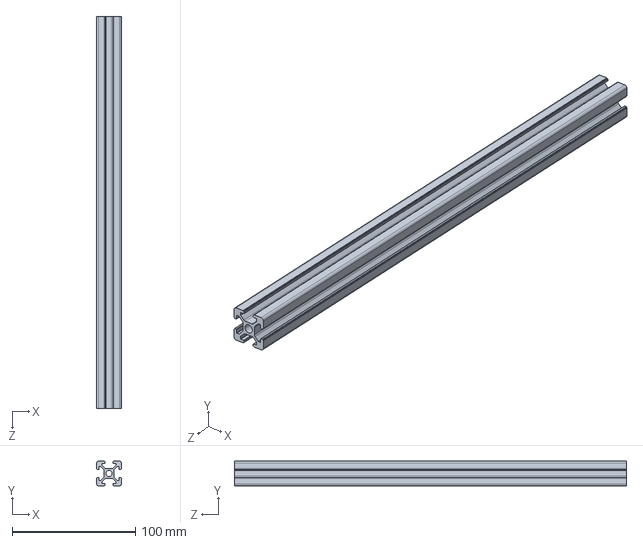
[picture p41: CAD file, 2021-02-22]
Bioreactor design/Aluminum 20mm t slot 12.5in.SLDPRT
20.0 x 20.0 x 317.5 mm
