Szczesnytendon/Bioreactor/Bioreactor design/Pulley.SLDPRT

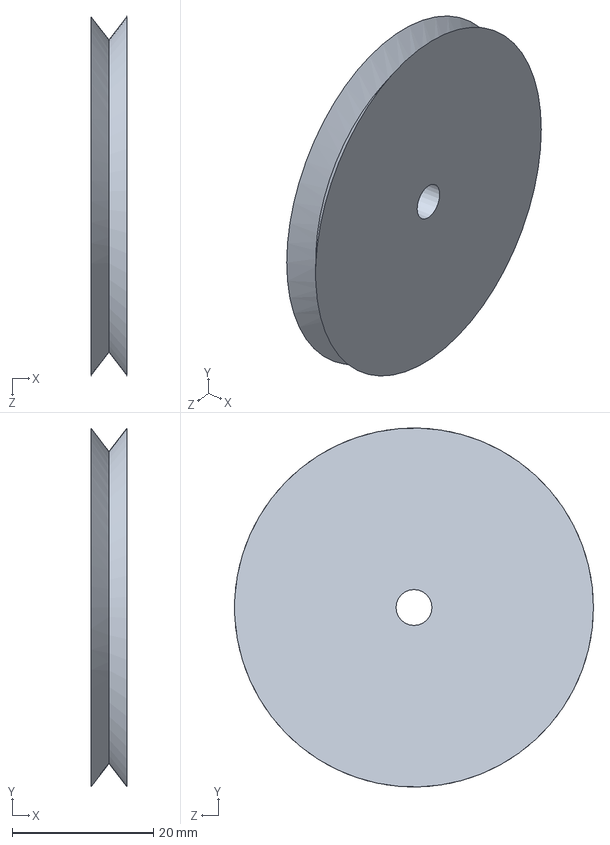
[picture p42: CAD file, 2021-02-22]
Bioreactor design/Pulley.SLDPRT
5.08 x 50.8 x 50.8 mm
