Szczesnytendon/Bioreactor/Bioreactor design/6-32 Threaded rod.SLDPRT

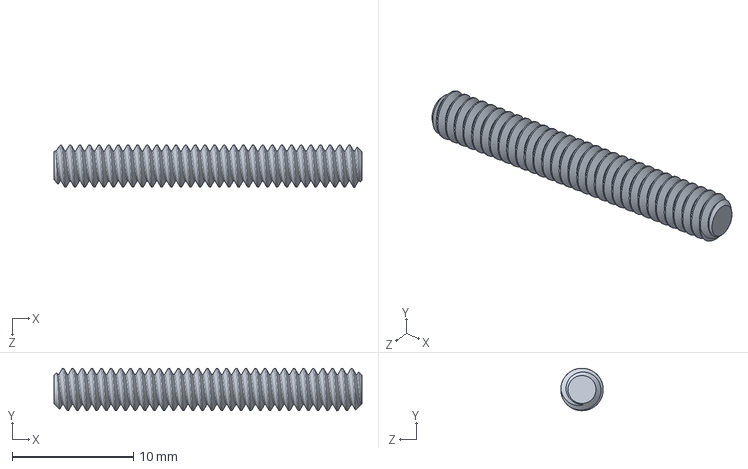
[picture p43: CAD file, 2021-02-22]
Bioreactor design/6-32 Threaded rod.SLDPRT
25.4 x 3.51 x 3.51 mm
