Szczesnytendon/Bioreactor/Bioreactor design/6-32 threaded rod 0.75inch.SLDPRT

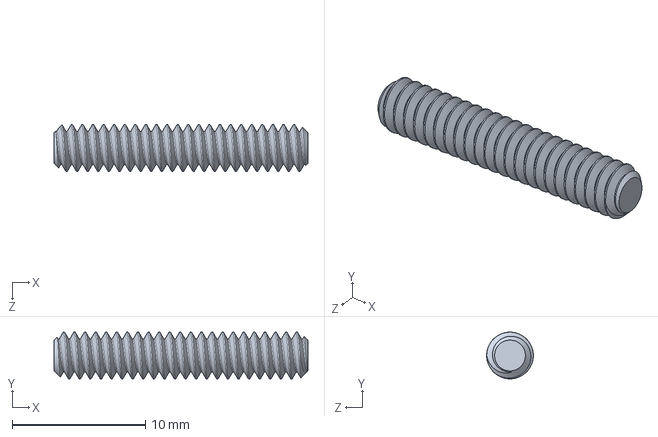
[picture p44: CAD file, 2021-02-22]
Bioreactor design/6-32 threaded rod 0.75inch.SLDPRT
19.1 x 3.51 x 3.51 mm
