Szczesnytendon/Bioreactor/Bioreactor design/Load cell thread adapter.SLDPRT

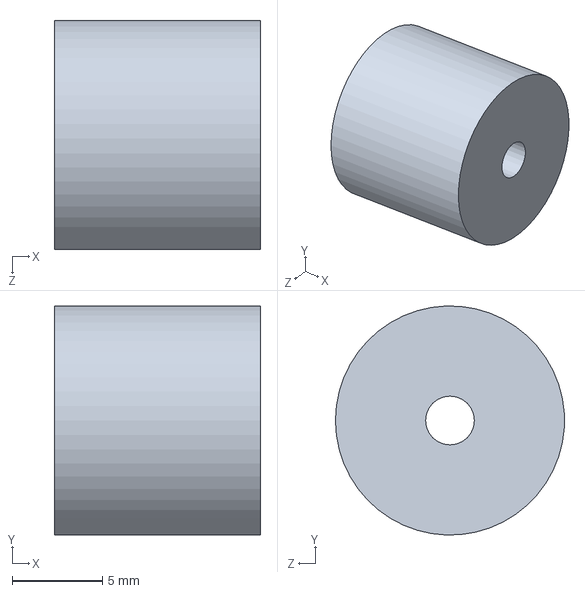
[picture p45: CAD file, 2021-02-22]
Bioreactor design/Load cell thread adapter.SLDPRT
11.4 x 12.7 x 12.7 mm
