Szczesnytendon/Bioreactor/(list of files, cad)

Other CAD files:
Bioreactor design/Grips/Serrated grip assem.SLDASM
Bioreactor design/Grips/Flat Grip.SLDPRT
Bioreactor design/Grips/Serrated grip right.SLDPRT
Bioreactor design/Movable grip holder.SLDPRT
Bioreactor design/6-32 Nut.SLDPRT
Bioreactor design/Drawings/Back plate.SLDDRW
Bioreactor design/Drawings/Base plate.SLDDRW
Bioreactor design/Drawings/Core connecting rod.SLDDRW
Bioreactor design/Drawings/Core mount.SLDDRW
Bioreactor design/Drawings/Fixed Grip holder.SLDDRW
Bioreactor design/Drawings/LVDT mount.SLDDRW
Bioreactor design/Drawings/Load cell plate.SLDDRW
Bioreactor design/Drawings/Load cell substitute.SLDDRW
Bioreactor design/Drawings/Load cell thread adapter.SLDDRW
Bioreactor design/Drawings/Movable grip holder.SLDDRW
Bioreactor design/Drawings/Plastic block under the fixed grip.SLDDRW
Bioreactor design/Drawings/Plastic block under the movable grip.SLDDRW
Bioreactor design/Drawings/Pulley base.SLDDRW
Bioreactor design/Grips/Drawings/Flat Grip Clamp.SLDDRW
Bioreactor design/Grips/Drawings/Flat Grips.SLDDRW
Bioreactor design/Grips/Drawings/Serrated grip holder.SLDDRW
Bioreactor design/Grips/Drawings/Serrated grip left.SLDDRW
Bioreactor design/Grips/Drawings/Serrated grip right.SLDDRW
Bioreactor design/Pulley screws.SLDPRT
