Szczesnytendon/Bioreactor/Wiring Diagram.pdf

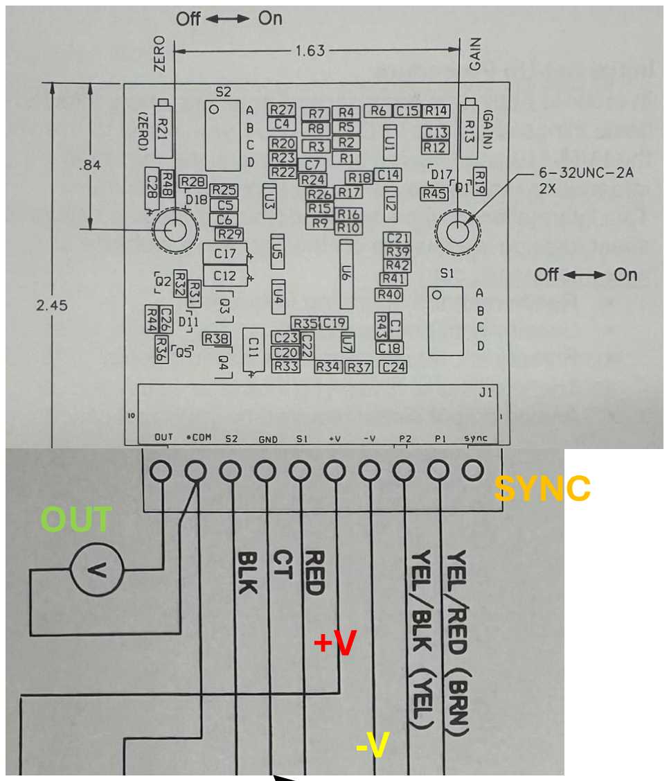
[picture p46: figure]
SYNC; OUT

CT= Blue + Green LVDT wires

COM

Overview of all Connections

Wires from LVDT | Wires from Power | Other Wires
Yellow/Red | -V | SYNC (runs between controllers)
Yellow/Black | +V | OUT (to DAQ)
Red | COM (Common Ground)

Blue AND Green (labeled CT on diagrams)

Black

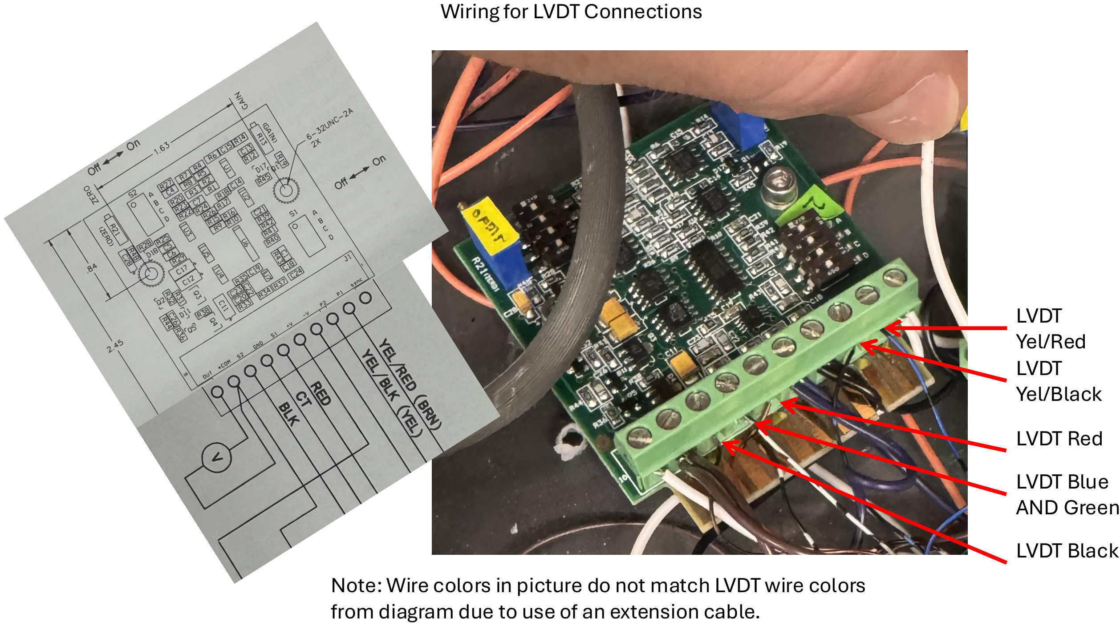
[picture p47: page 2]

LVDT
Yel/Red
LVDT
Yel/Black
LVDT Red
LVDT Blue
AND Green
LVDT Black

Wiring for LVDT Connections

Note: Wire colors in picture do not match LVDT wire colors from diagram due to use of an extension cable.

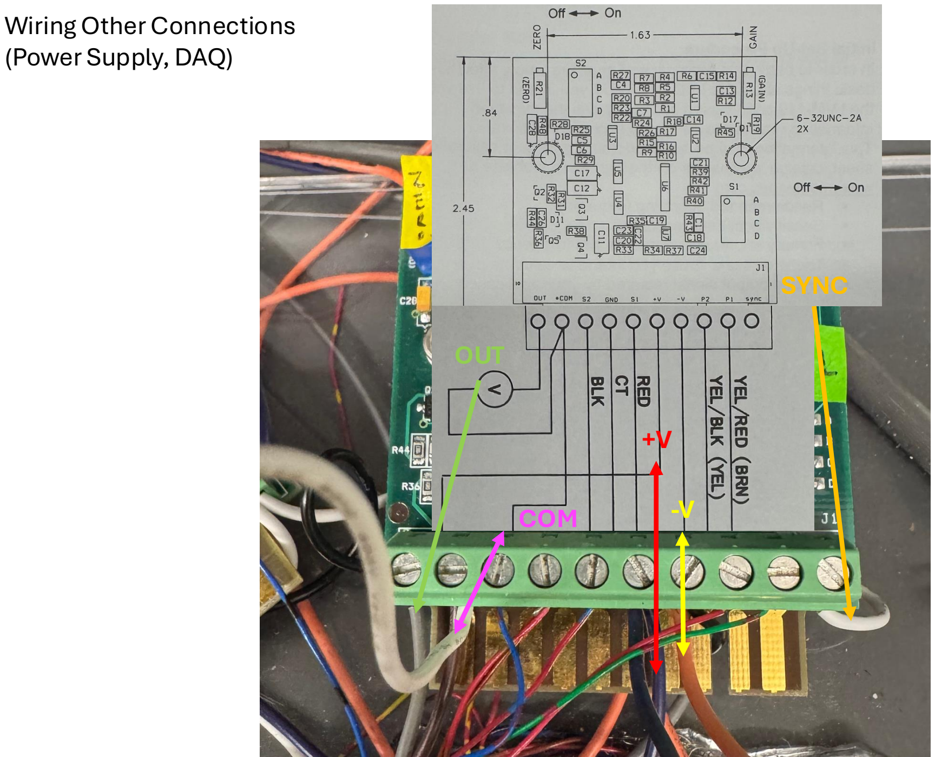
[picture p48: page 3]

Wiring Other Connections
(Power Supply, DAQ)

-V

+V

OUT

SYNC

COM

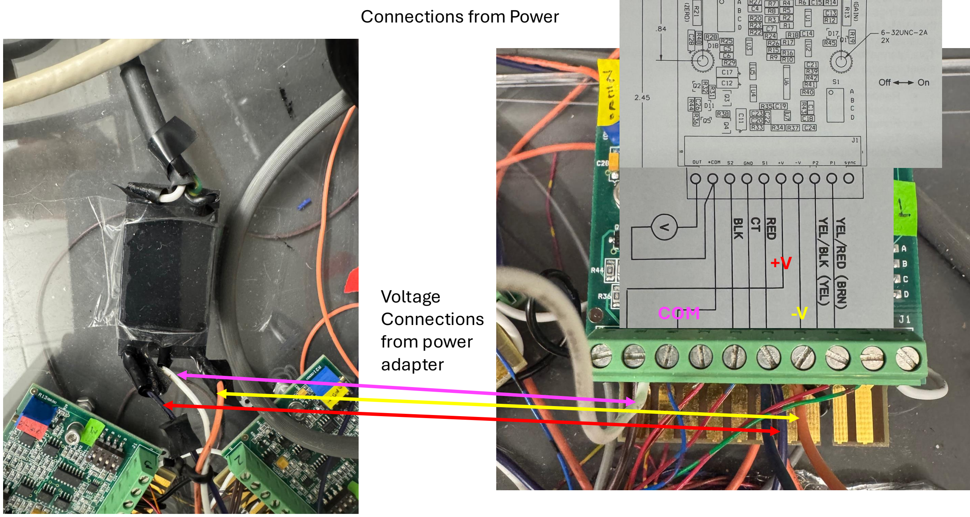
[picture p49: page 4]

Connections from Power

Voltage
Connections
from power
adapter

-V

+V

COM

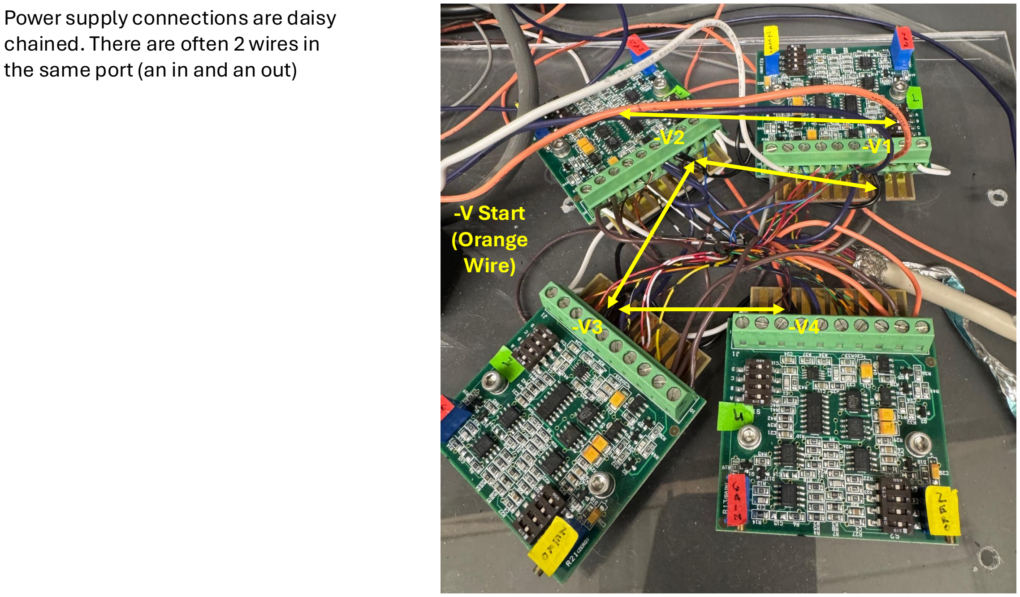
[picture p50: page 5]

-V Start
(Orange
Wire)

-V1 -V2

-V3 | -V4

Power supply connections are daisy chained. There are often 2 wires in the same port (an in and an out)

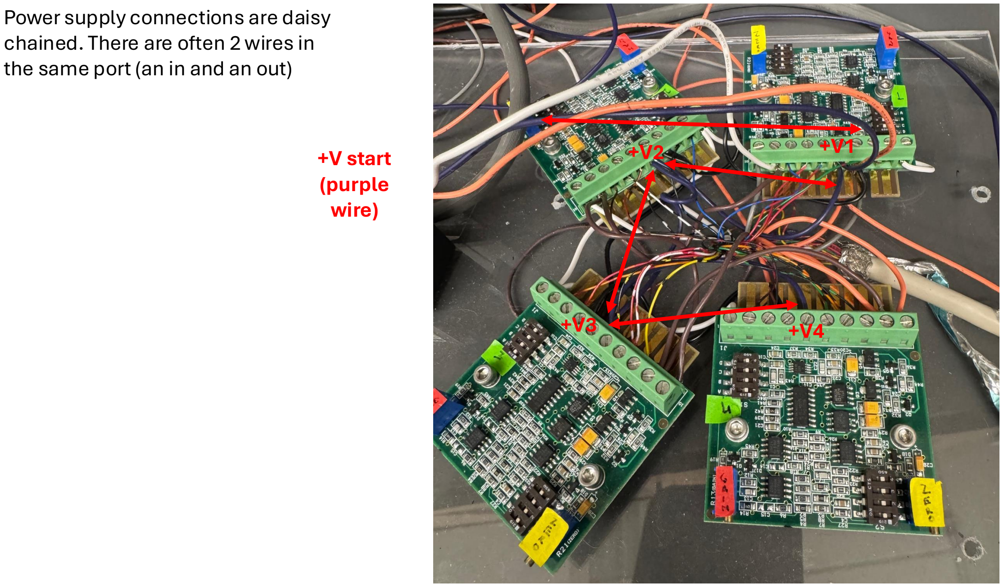
[picture p51: page 6]

+V start
(purple
wire)

+V1 +V2

+V3 | +V4

Power supply connections are daisy chained. There are often 2 wires in the same port (an in and an out)

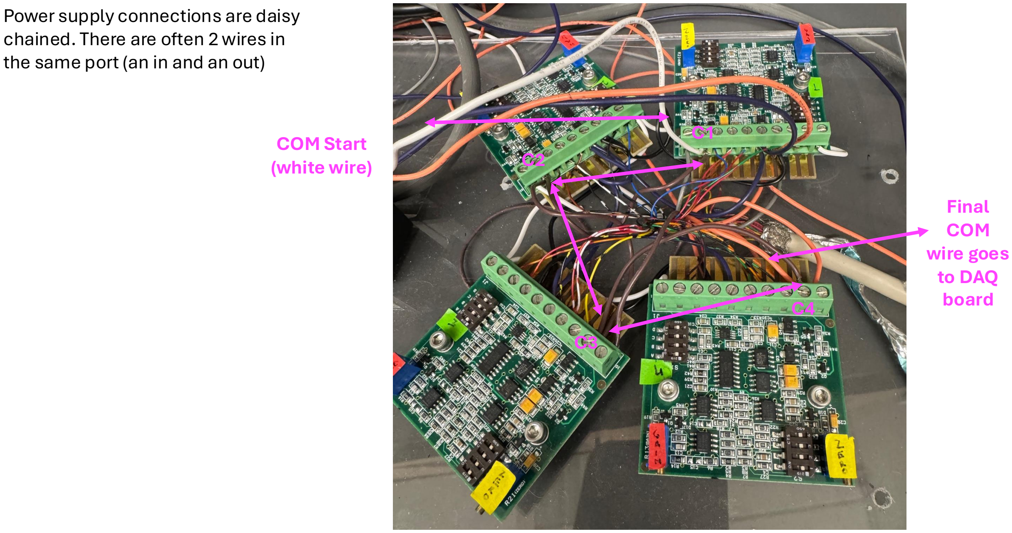
[picture p52: page 7]

COM Start
(white wire)

C1
C2

C3

C4

Final
COM
wire goes
to DAQ
board

Power supply connections are daisy chained. There are often 2 wires in the same port (an in and an out)

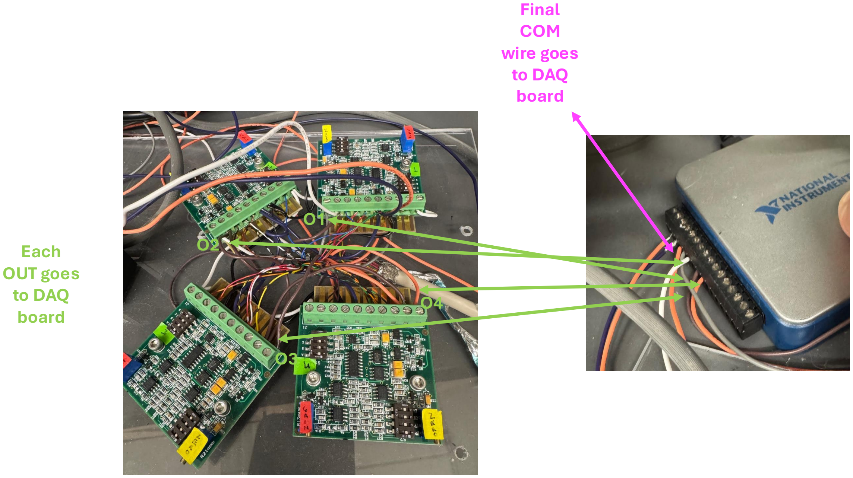
[picture p53: page 8]

Each
OUT goes
to DAQ
board

Final
COM
wire goes
to DAQ
board

O4

O2

O3

O1

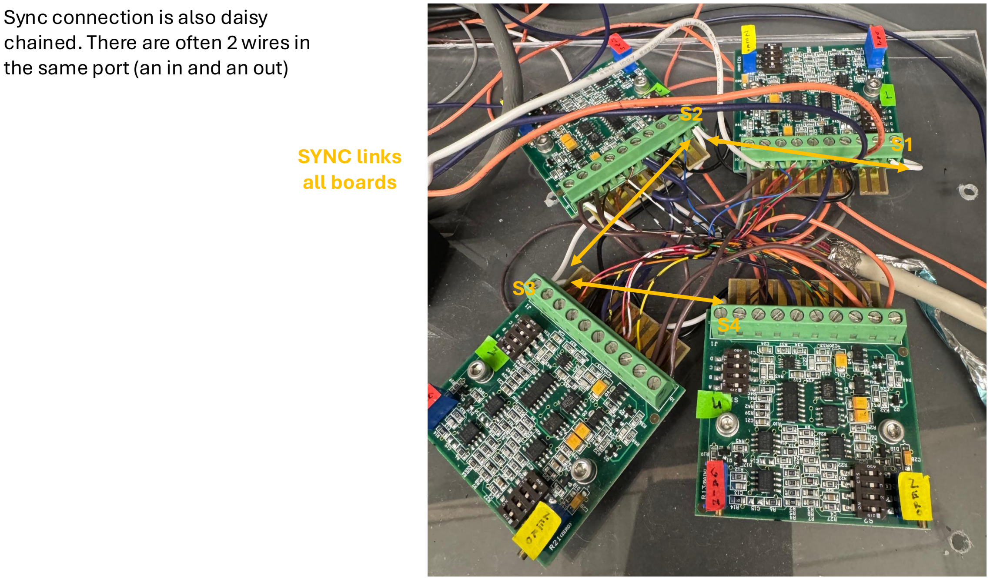
[picture p54: page 9]

Sync connection is also daisy chained. There are often 2 wires in the same port (an in and an out)

SYNC links
all boards

S1

S2

S3
S4
