Szczesnytendon/Bioreactor/Bioreactor design/Drawings/PDFs/Back plate.PDF

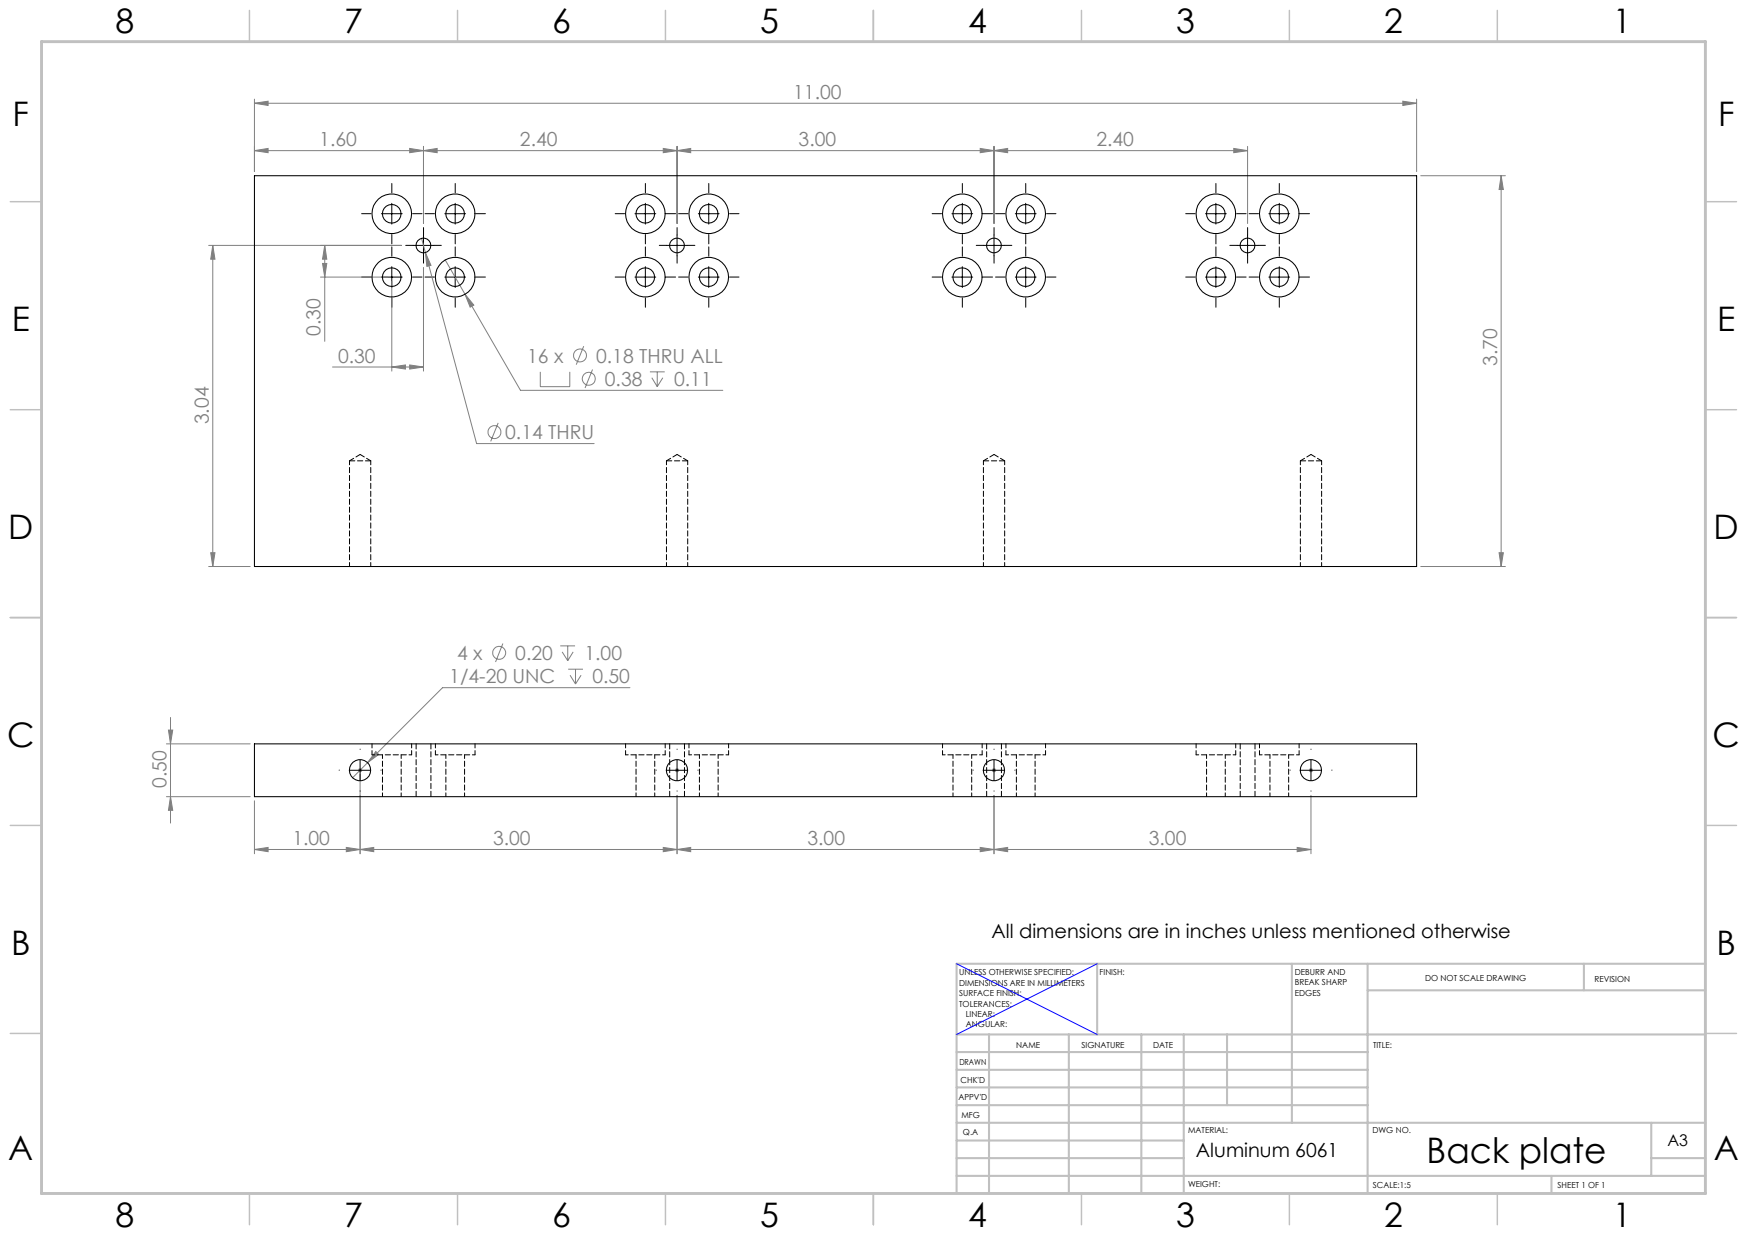
[picture p55: page 1]
0.18 THRU ALL; 0.14 THRU; 1/4-20 UNC; Aluminum 6061; FINISH:; DEBURR AND; BREAK SHARP; DO NOT SCALE DRAWING; REVISION; SCALE:1:5; SHEET 1 OF 1

All dimensions are in inches unless mentioned otherwise

UNLESS OTHERWISE SPECIFIED:
DIMENSIONS ARE IN MILLIMETERS
SURFACE FINISH:
TOLERANCES:
LINEAR:
ANGULAR:

NAME | SIGNATURE | DATE | | | | TITLE:

DRAWN
CHK'D
APPV'D
MFG
Q.A | | | | MATERIAL: | DWG NO. Back plate | A3
