Szczesnytendon/Bioreactor/Bioreactor design/Drawings/PDFs/Base plate.PDF

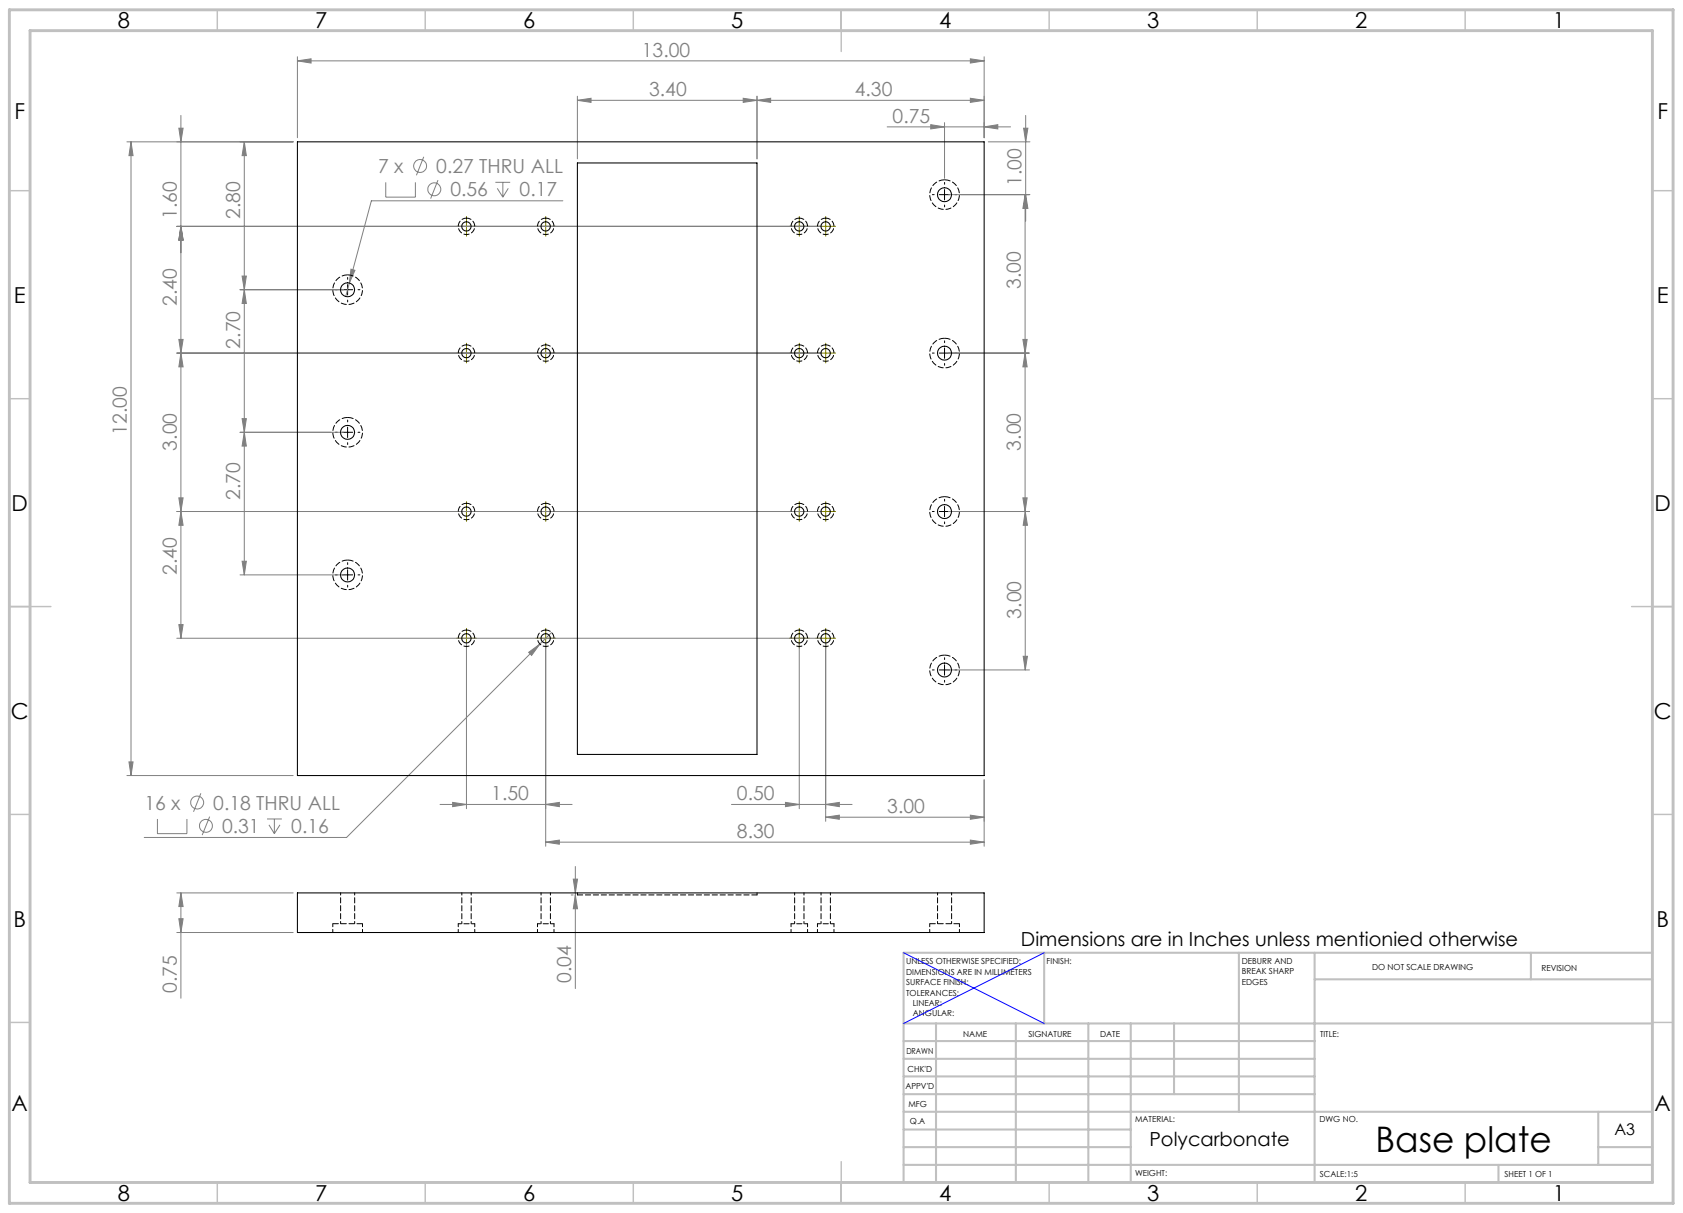
[picture p56: page 1]
0.27 THRU ALL; 0.18 THRU ALL; FINISH:; DEBURR AND; BREAK SHARP; DO NOT SCALE DRAWING; REVISION; SCALE:1:5; SHEET 1 OF 1

Dimensions are in Inches unless mentionied otherwise

UNLESS OTHERWISE SPECIFIED:
DIMENSIONS ARE IN MILLIMETERS
SURFACE FINISH:
TOLERANCES:
LINEAR:
ANGULAR:

NAME | SIGNATURE | DATE | | | | TITLE:

DRAWN
CHK'D
APPV'D
MFG
Q.A | | | | MATERIAL: Polycarbonate | DWG NO. Base plate | A3
