Szczesnytendon/Bioreactor/Bioreactor design/Drawings/PDFs/Core connecting rod.PDF

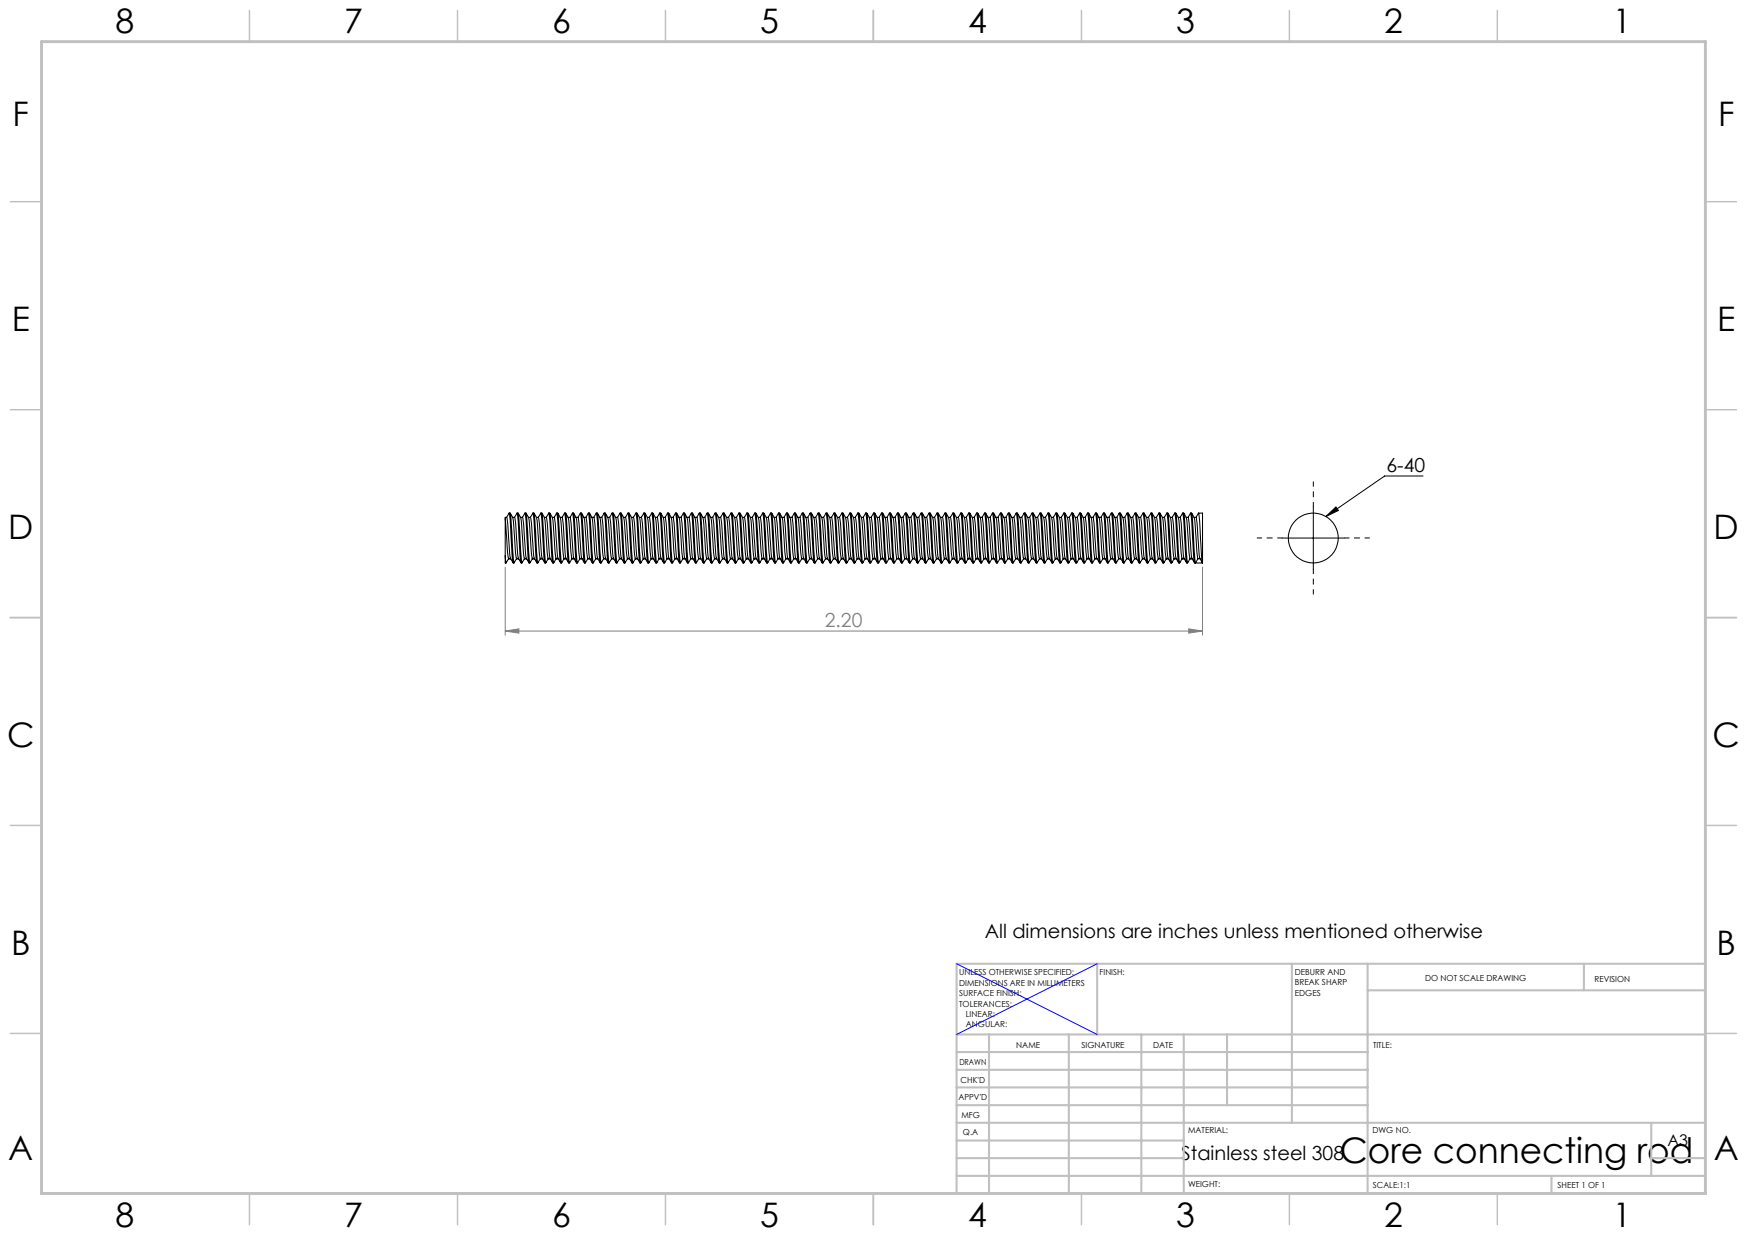
[picture p57: page 1]
Stainless steel 308; FINISH:; DEBURR AND; BREAK SHARP; DO NOT SCALE DRAWING; REVISION; SCALE:1:1; SHEET 1 OF 1

All dimensions are inches unless mentioned otherwise

UNLESS OTHERWISE SPECIFIED:
DIMENSIONS ARE IN MILLIMETERS
SURFACE FINISH:
TOLERANCES:
LINEAR:
ANGULAR:

NAME | SIGNATURE | DATE | | | | TITLE:

DRAWN
CHK'D
APPV'D
MFG
Q.A | | | | MATERIAL: Core connecting rod | DWG NO. | A3
