Szczesnytendon/Bioreactor/Bioreactor design/Drawings/PDFs/Core mount.PDF

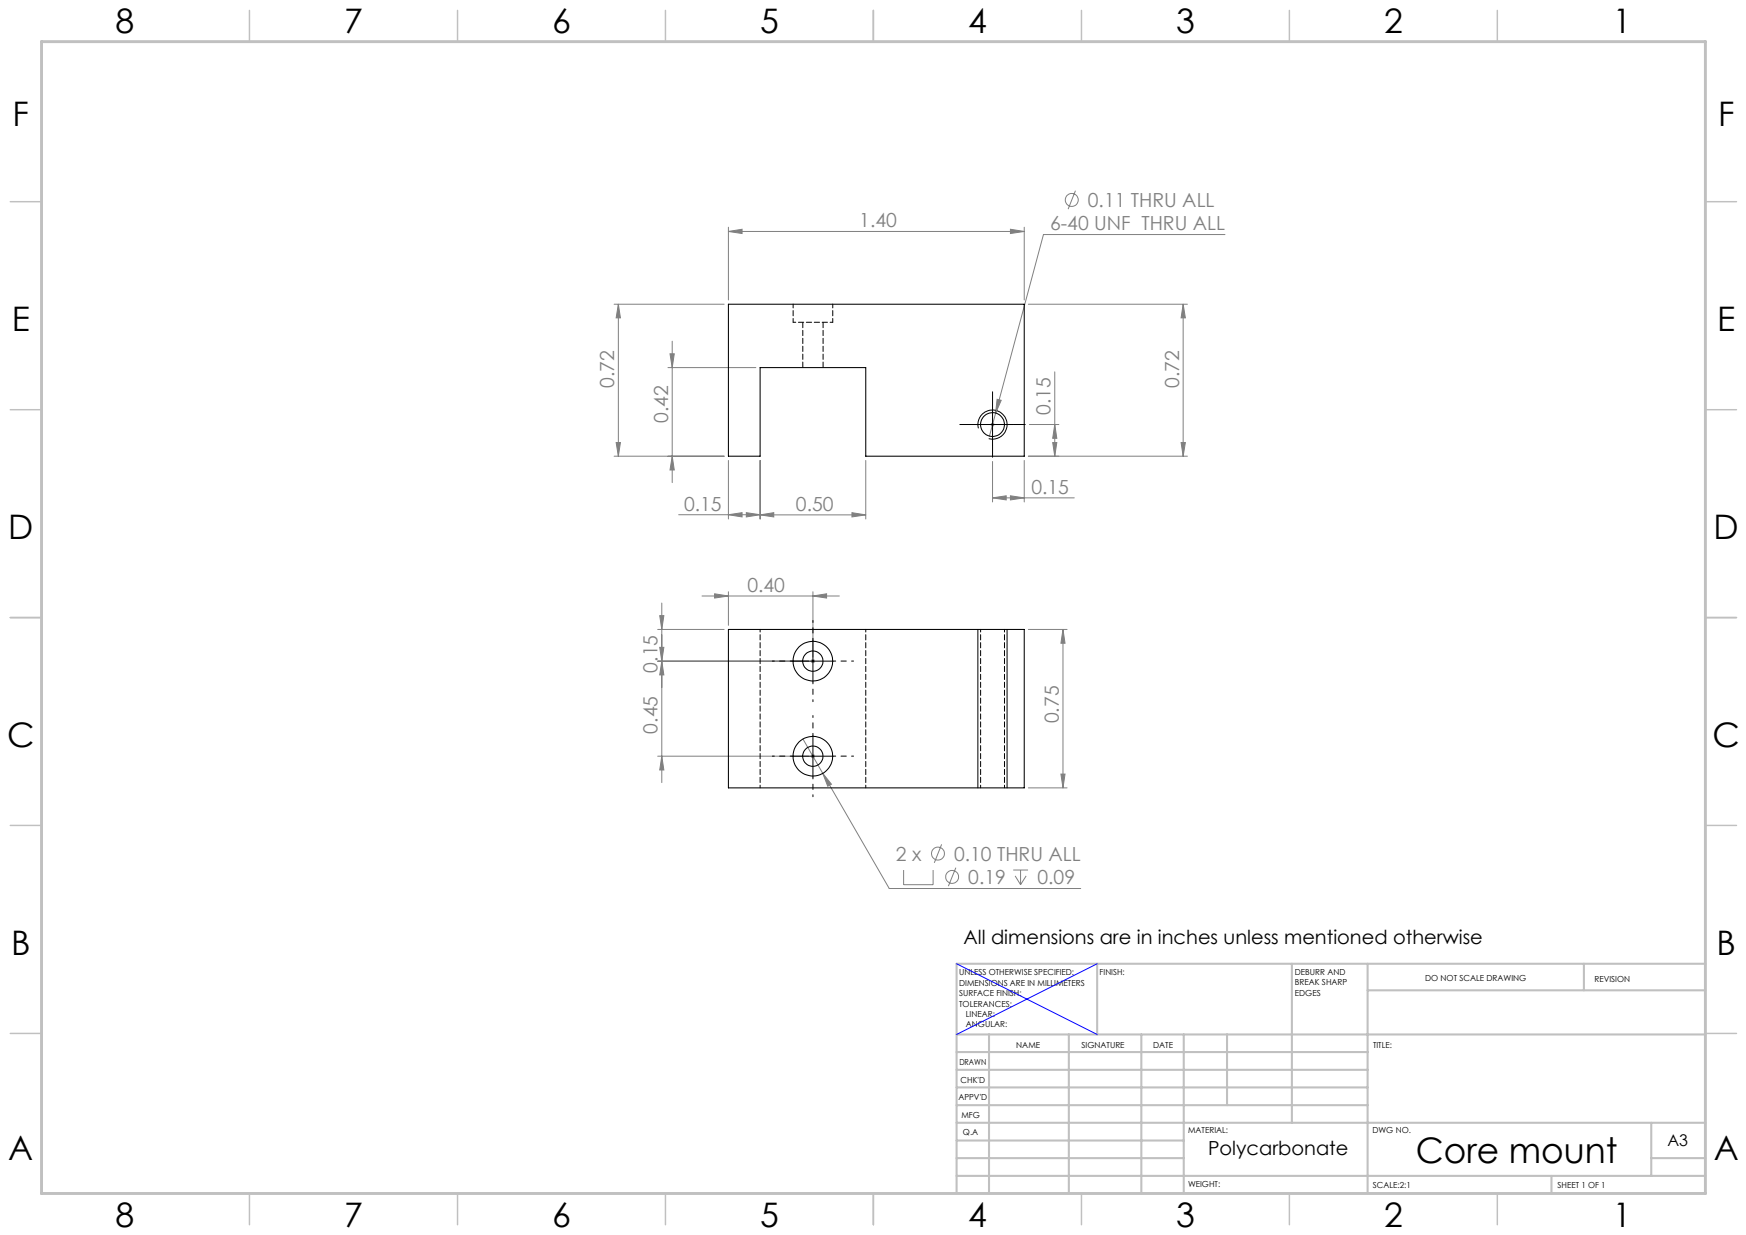
[picture p58: page 1]
0.10 THRU ALL; FINISH:; DEBURR AND; BREAK SHARP; DO NOT SCALE DRAWING; REVISION; SCALE:2:1; SHEET 1 OF 1

0.11 THRU ALL
6-40 UNF THRU ALL

All dimensions are in inches unless mentioned otherwise

UNLESS OTHERWISE SPECIFIED:
DIMENSIONS ARE IN MILLIMETERS
SURFACE FINISH:
TOLERANCES:
LINEAR:
ANGULAR:

NAME | SIGNATURE | DATE | | | | TITLE:

DRAWN
CHK'D
APPV'D
MFG
Q.A | | | | MATERIAL: | DWG NO. Core mount | A3
