Szczesnytendon/Bioreactor/Bioreactor design/Drawings/PDFs/Fixed Grip holder.PDF

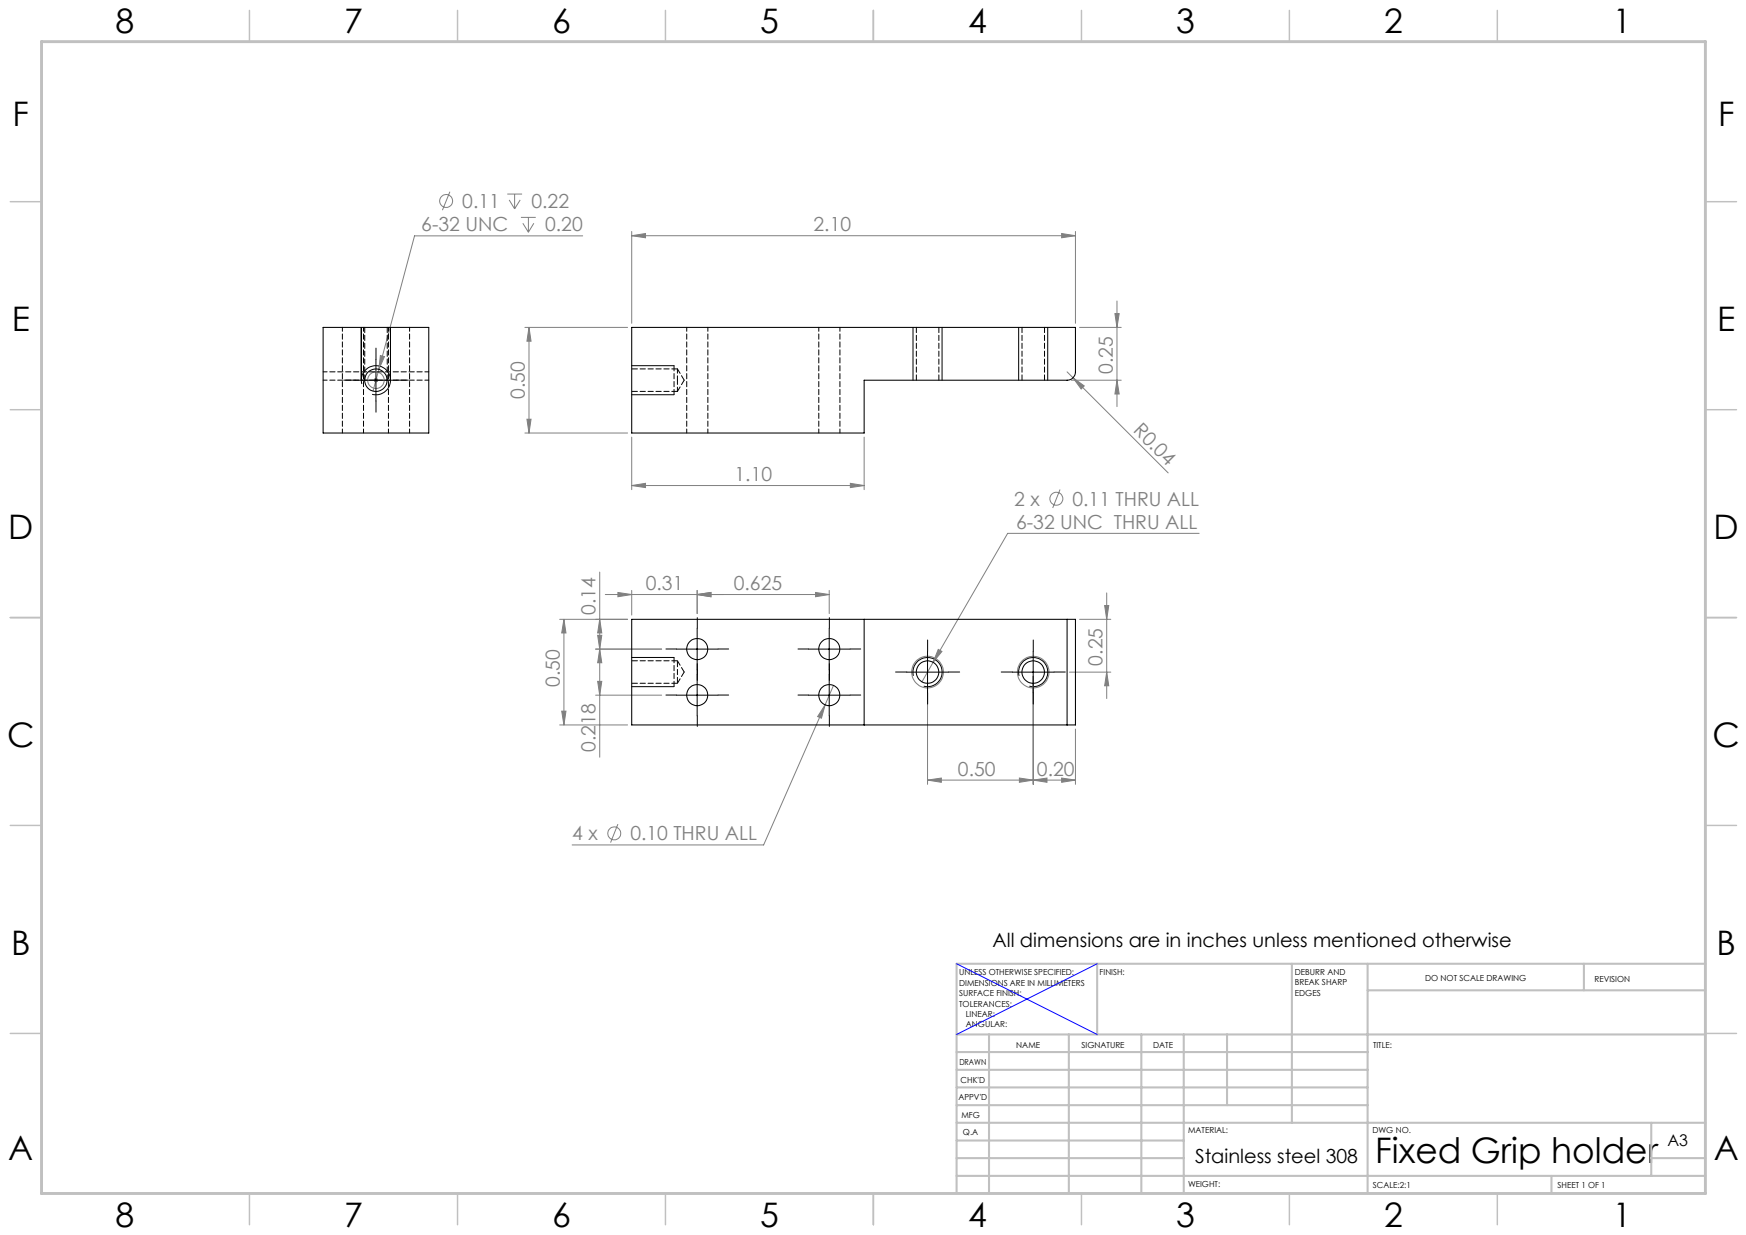
[picture p59: page 1]
0.11 THRU ALL; 0.10 THRU ALL; 6-32 UNC; Stainless steel 308; FINISH:; DEBURR AND; BREAK SHARP; DO NOT SCALE DRAWING; REVISION; SCALE:2:1; SHEET 1 OF 1

6-32 UNC THRU ALL

All dimensions are in inches unless mentioned otherwise

UNLESS OTHERWISE SPECIFIED:
DIMENSIONS ARE IN MILLIMETERS
SURFACE FINISH:
TOLERANCES:
LINEAR:
ANGULAR:

NAME | SIGNATURE | DATE | | | | TITLE:

DRAWN
CHK'D
APPV'D
MFG
Q.A | | | | MATERIAL: | DWG NO. Fixed Grip holder | A3
