Szczesnytendon/Bioreactor/Bioreactor design/Drawings/PDFs/Load cell plate.PDF

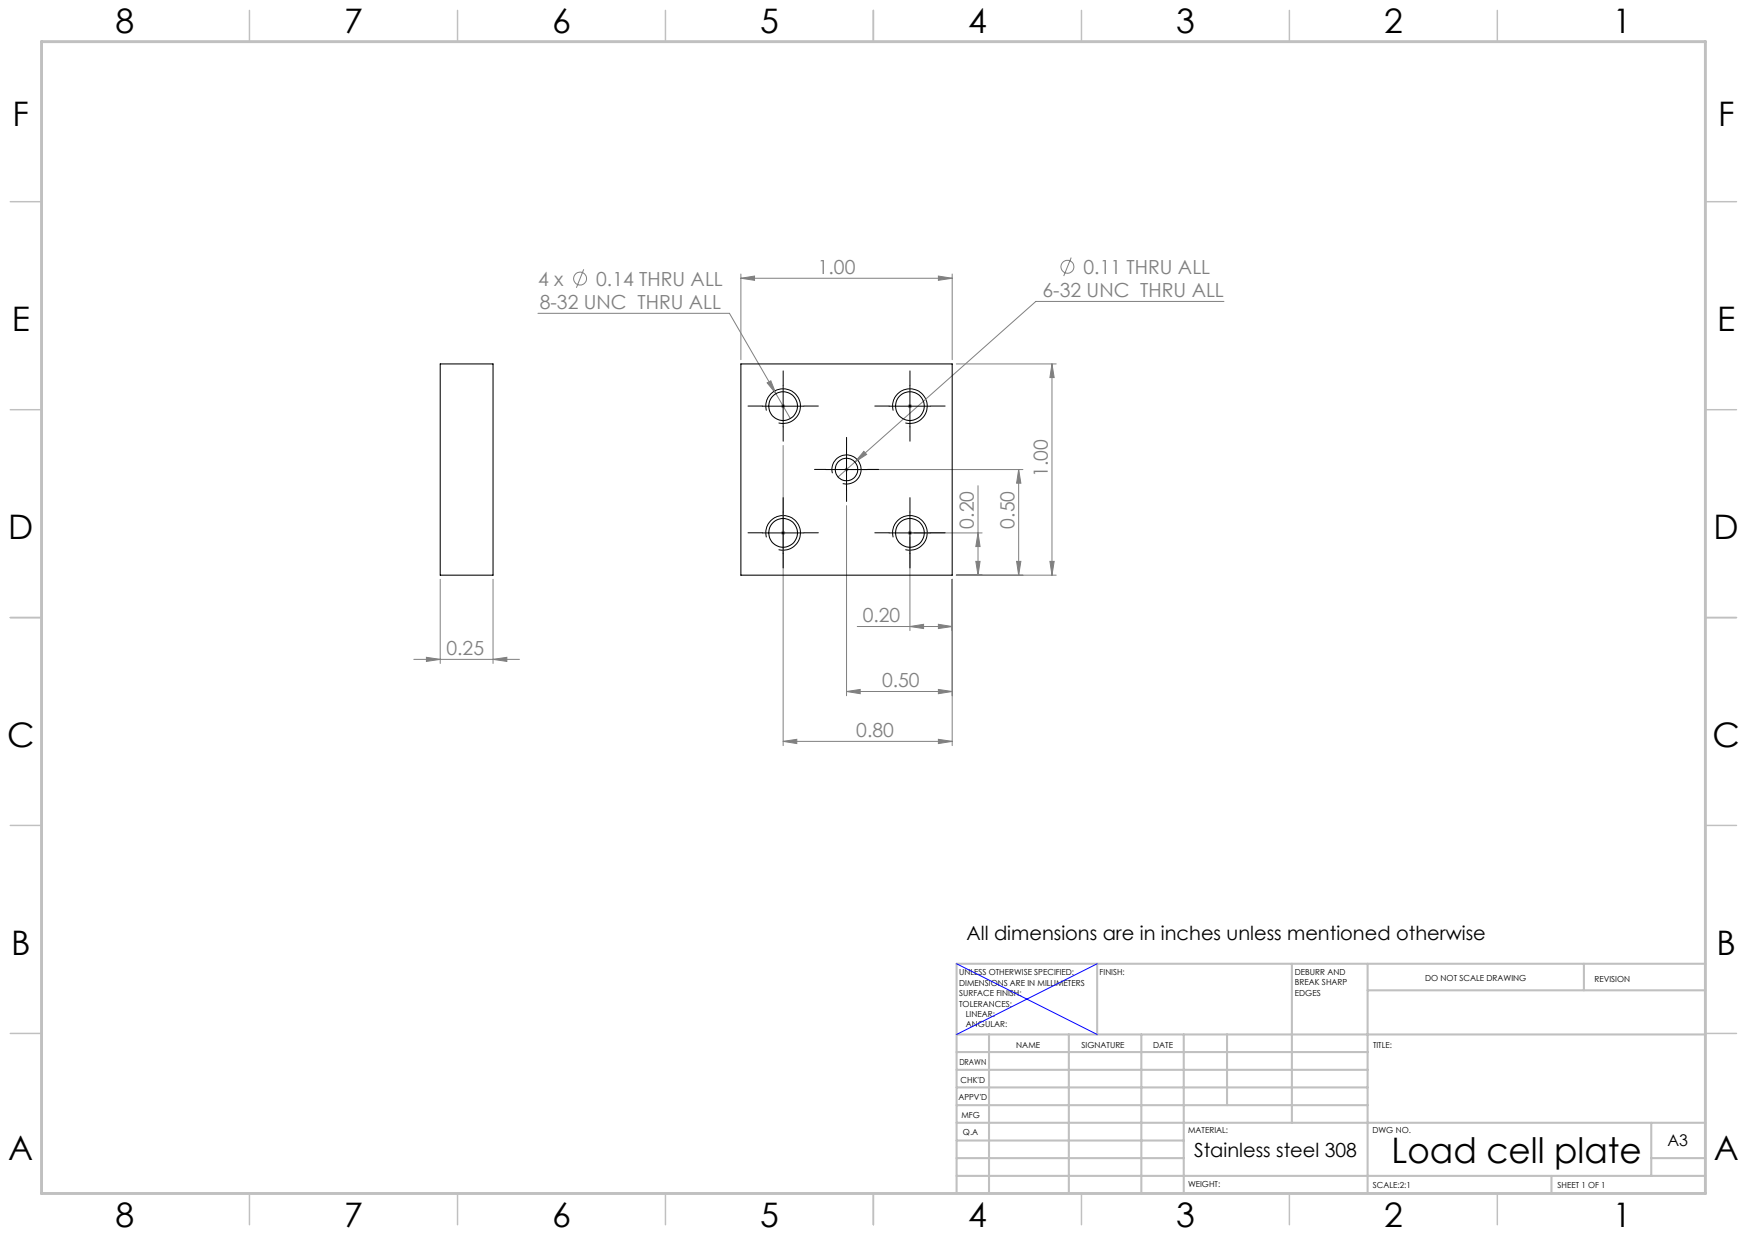
[picture p60: page 1]
0.11 THRU ALL; 6-32 UNC THRU ALL 4 x; 0.14 THRU ALL; Stainless steel 308; FINISH:; DEBURR AND; BREAK SHARP; DO NOT SCALE DRAWING; REVISION; SCALE:2:1; SHEET 1 OF 1

8-32 UNC THRU ALL

All dimensions are in inches unless mentioned otherwise

UNLESS OTHERWISE SPECIFIED:
DIMENSIONS ARE IN MILLIMETERS
SURFACE FINISH:
TOLERANCES:
LINEAR:
ANGULAR:

NAME | SIGNATURE | DATE | | | | TITLE:

DRAWN
CHK'D
APPV'D
MFG
Q.A | | | | MATERIAL: | DWG NO. Load cell plate | A3
