Szczesnytendon/Bioreactor/Bioreactor design/Drawings/PDFs/Load cell substitute.PDF

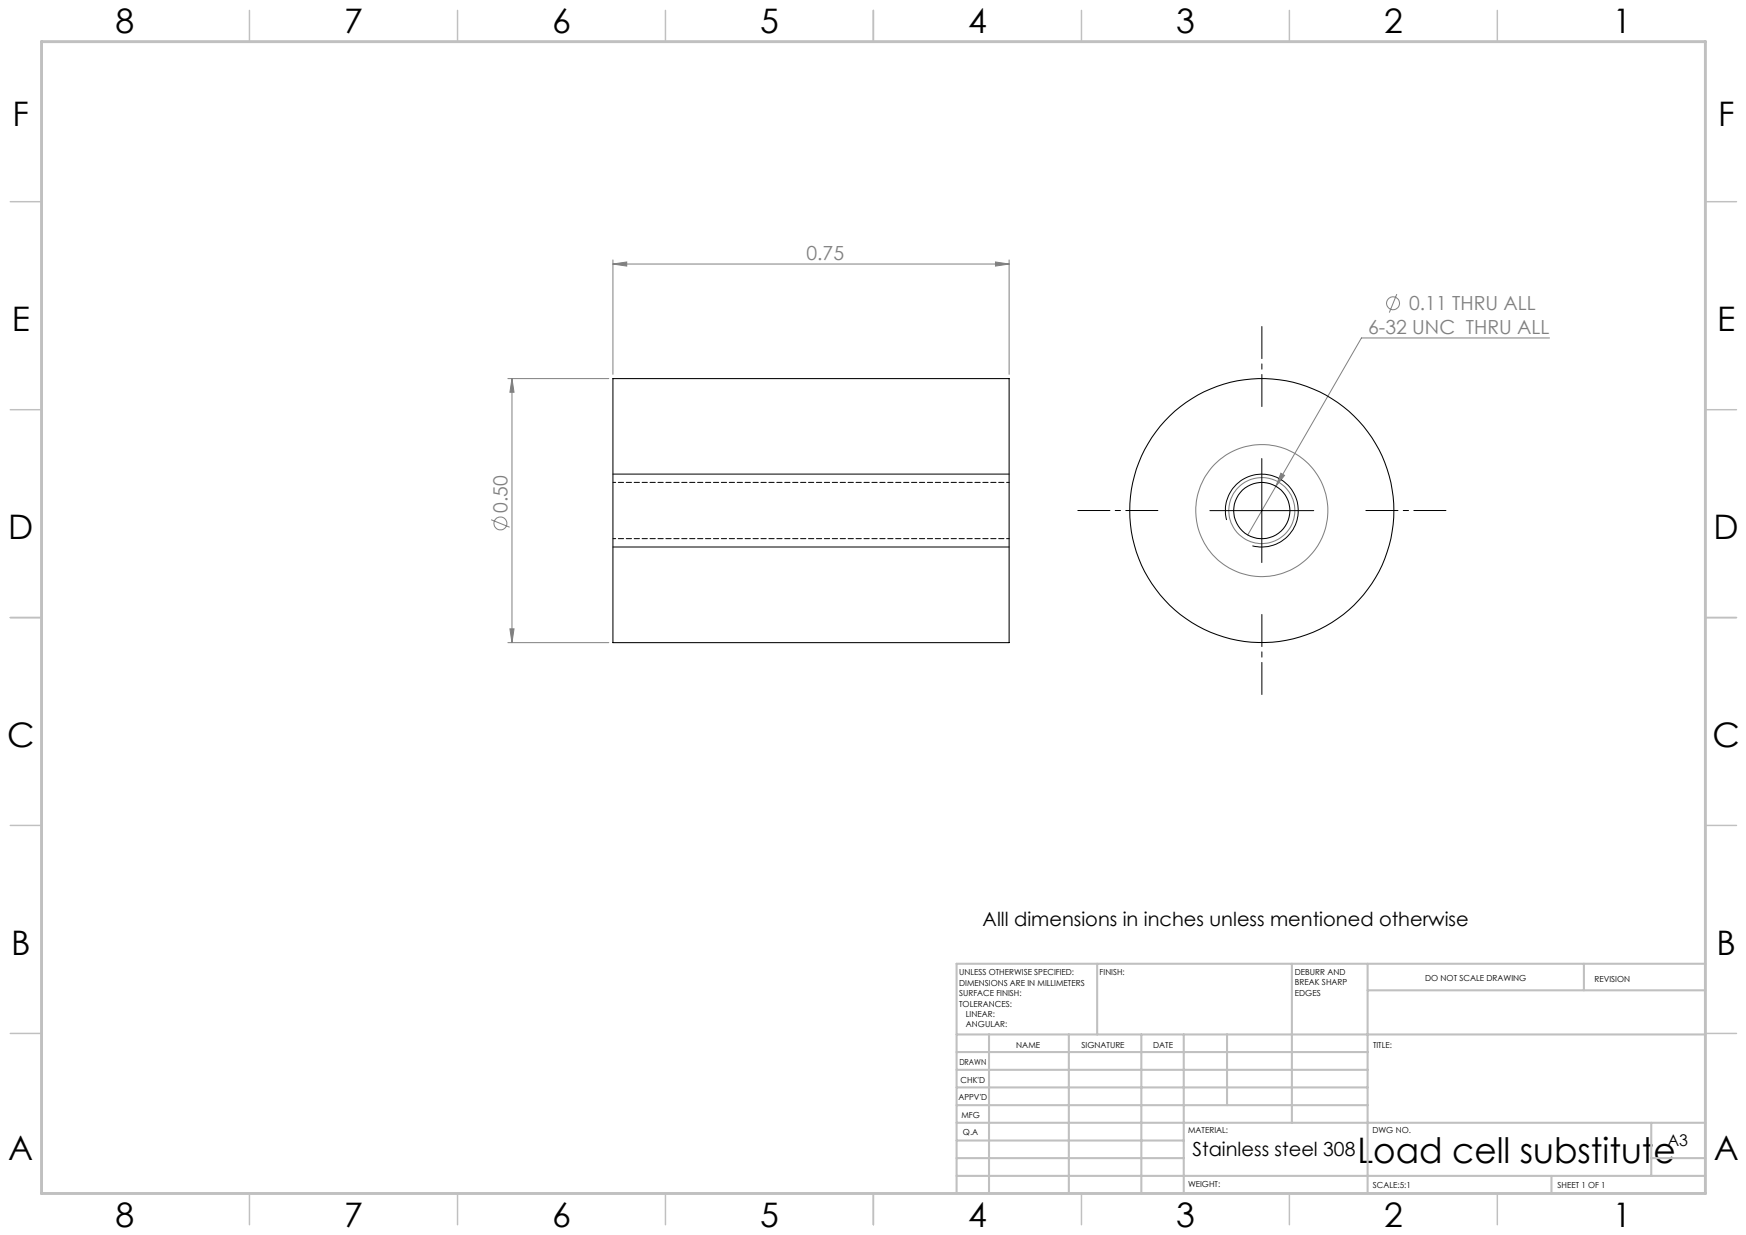
[picture p61: page 1]
Stainless steel 308; FINISH:; DEBURR AND; BREAK SHARP; DO NOT SCALE DRAWING; REVISION; SCALE:5:1; SHEET 1 OF 1

0.11 THRU ALL
6-32 UNC THRU ALL

Alll dimensions in inches unless mentioned otherwise

UNLESS OTHERWISE SPECIFIED:
DIMENSIONS ARE IN MILLIMETERS
SURFACE FINISH:
TOLERANCES:
LINEAR:
ANGULAR:

NAME | SIGNATURE | DATE | | | | TITLE:

DRAWN
CHK'D
APPV'D
MFG
Q.A | | | | MATERIAL: Load cell substitute | DWG NO. | A3
