Szczesnytendon/Bioreactor/Bioreactor design/Drawings/PDFs/LVDT mount.PDF

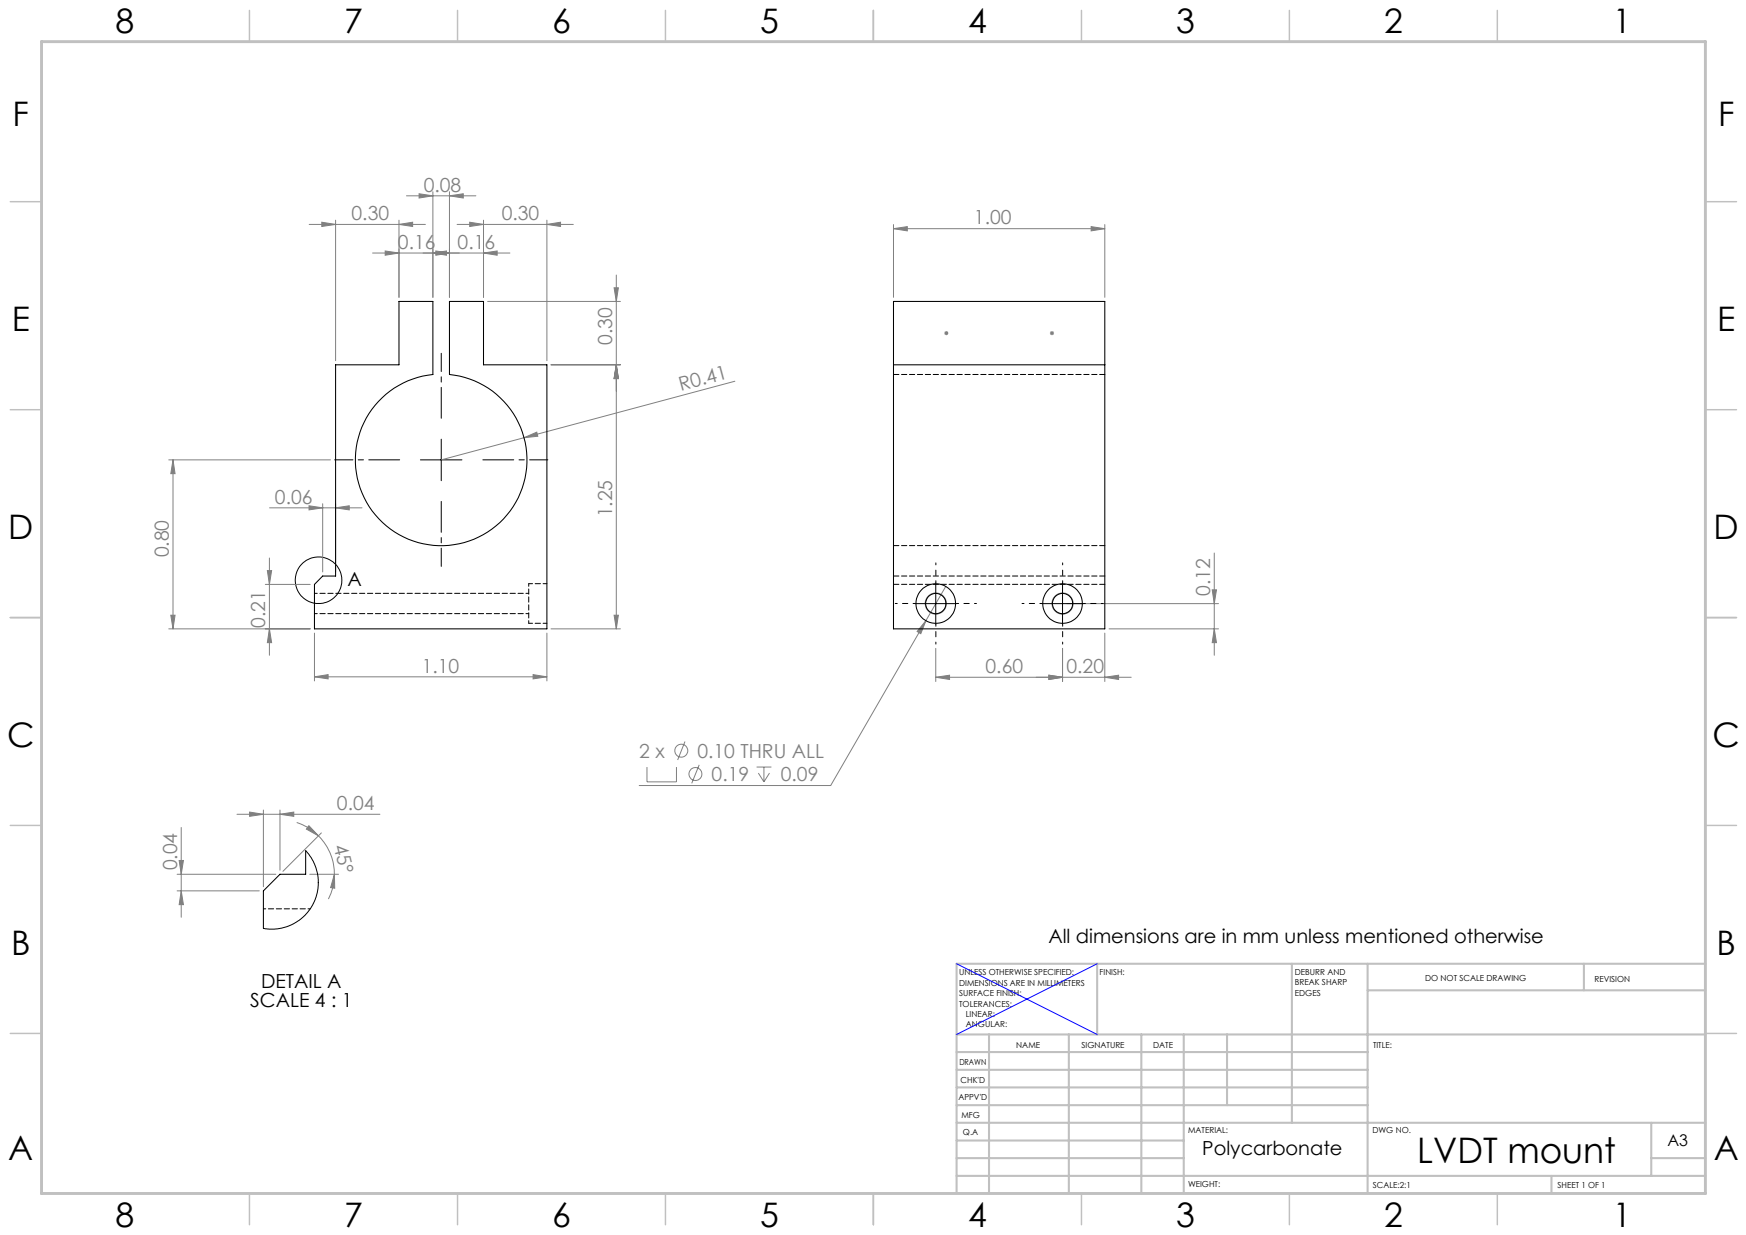
[picture p62: page 1]
0.10 THRU ALL; DETAIL A SCALE 4 : 1; FINISH:; DEBURR AND; BREAK SHARP; DO NOT SCALE DRAWING; REVISION; SCALE:2:1; SHEET 1 OF 1

All dimensions are in mm unless mentioned otherwise

UNLESS OTHERWISE SPECIFIED:
DIMENSIONS ARE IN MILLIMETERS
SURFACE FINISH:
TOLERANCES:
LINEAR:
ANGULAR:

NAME | SIGNATURE | DATE | | | | TITLE:

DRAWN
CHK'D
APPV'D
MFG
Q.A | | | | MATERIAL: | DWG NO. LVDT mount | A3
