Szczesnytendon/Bioreactor/Bioreactor design/Drawings/PDFs/Plastic block under the fixed grip.PDF

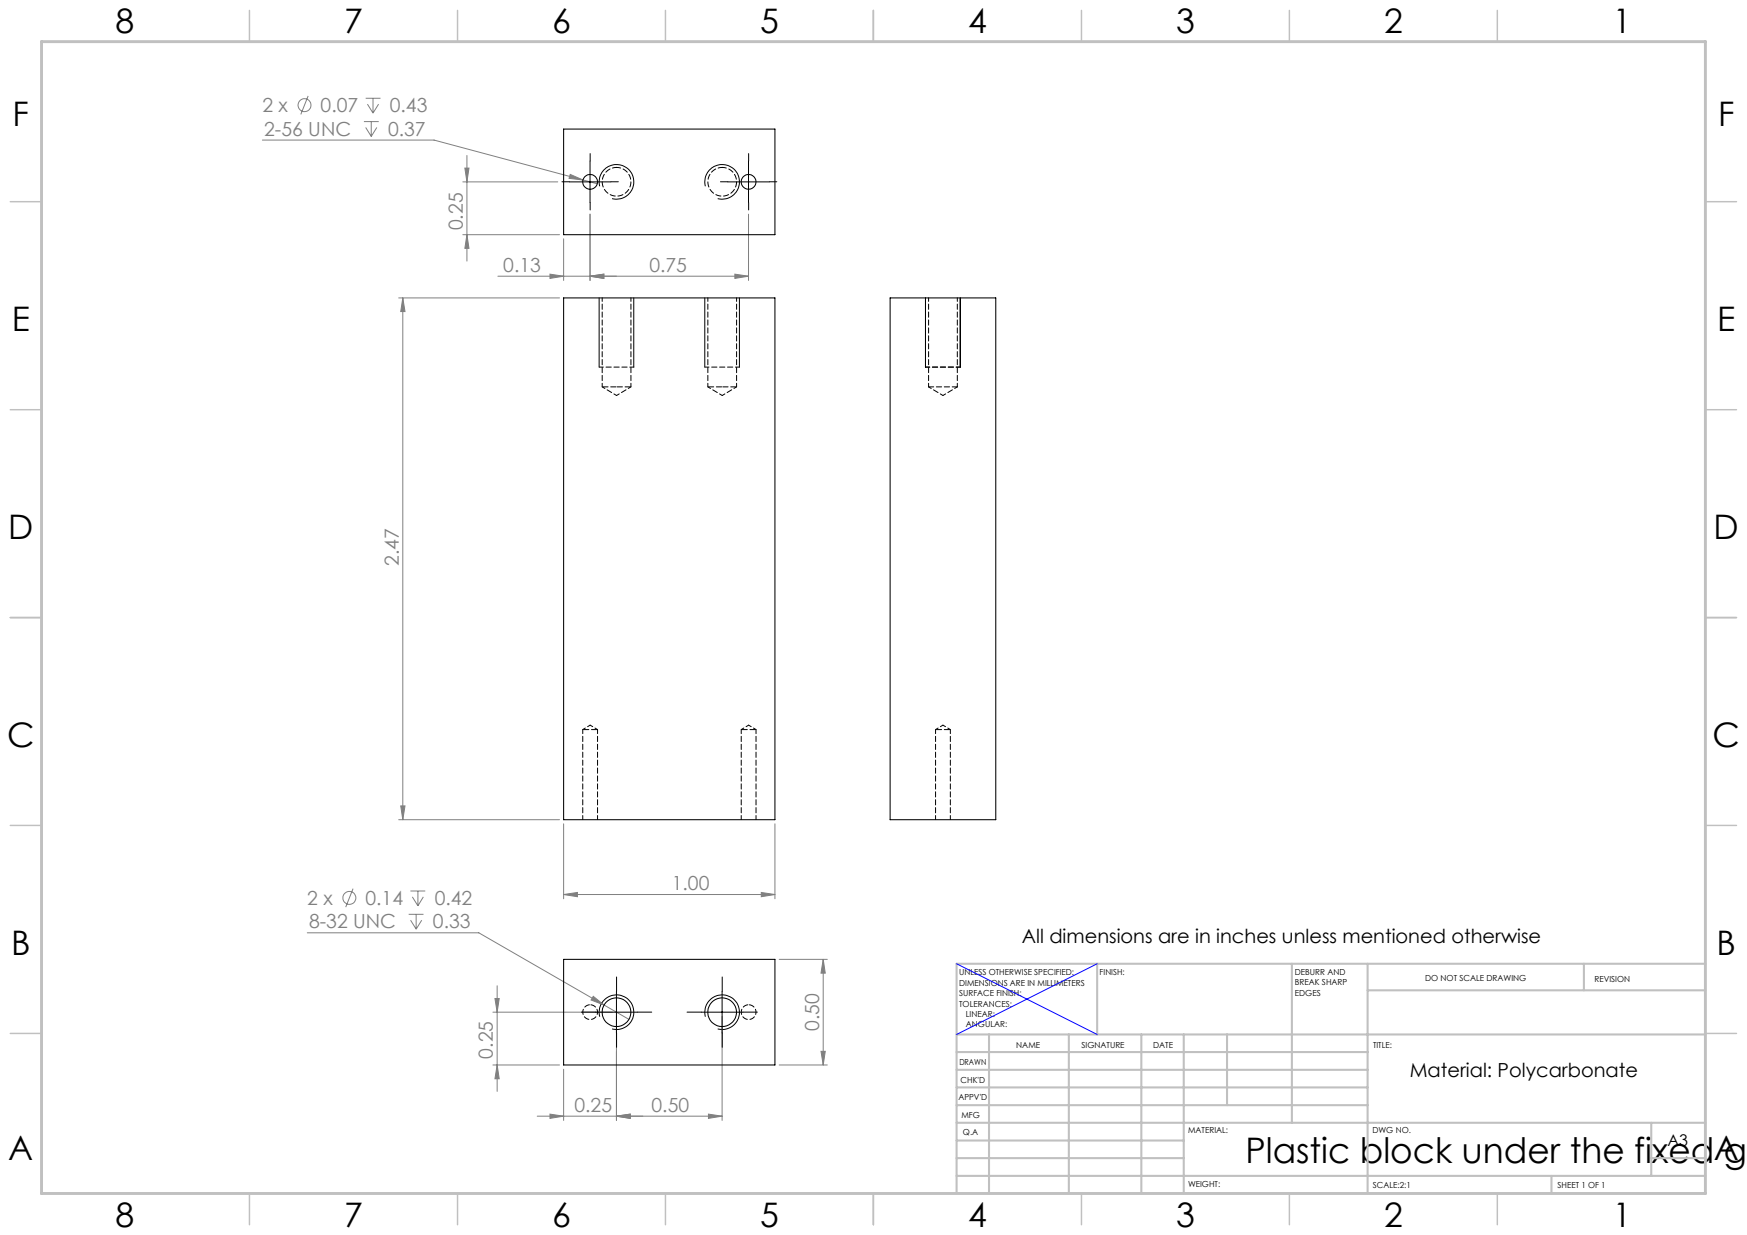
[picture p64: page 1]
2-56 UNC; 8-32 UNC; All dimensions are in inches unless mentioned otherwise; FINISH:; DEBURR AND; BREAK SHARP; DO NOT SCALE DRAWING; REVISION; SCALE:2:1; SHEET 1 OF 1

UNLESS OTHERWISE SPECIFIED:
DIMENSIONS ARE IN MILLIMETERS
SURFACE FINISH:
TOLERANCES:
LINEAR:
ANGULAR:

NAME | SIGNATURE | DATE | | | | TITLE: Material: Polycarbonate

DRAWN
CHK'D
APPV'D
MFG
Q.A | | | | MATERIAL: | DWG NO. | A3

Plastic block under the fixed grip
