Szczesnytendon/Bioreactor/Bioreactor design/Grips/Drawings/pdf/Flat Grip Clamp.PDF

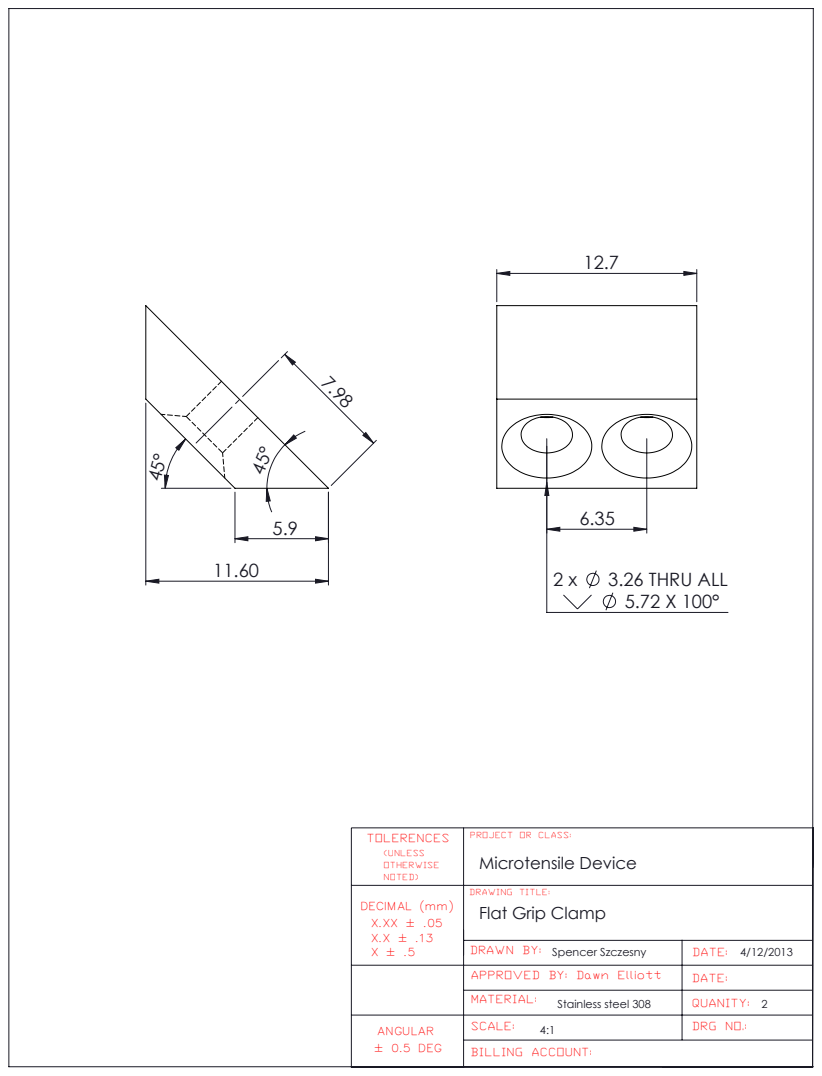
[picture p65: page 1]
3.26 THRU ALL; BILLING ACCOUNT:

TOLERENCES (UNLESS OTHERWISE NOTED) | PROJECT OR CLASS: Microtensile Device

DECIMAL (mm) X.XX ± .05 X.X ± .13 X ± .5 | DRAWING TITLE: Flat Grip Clamp

DRAWN BY: Spencer Szczesny | DATE: 4/12/2013
APPROVED BY: Dawn Elliott | DATE:
MATERIAL: Stainless steel 308 | QUANITY: 2

ANGULAR ± 0.5 DEG | SCALE: 4:1 | DRG NO.:
