Szczesnytendon/Bioreactor/Bioreactor design/Grips/Drawings/pdf/Flat Grip.PDF

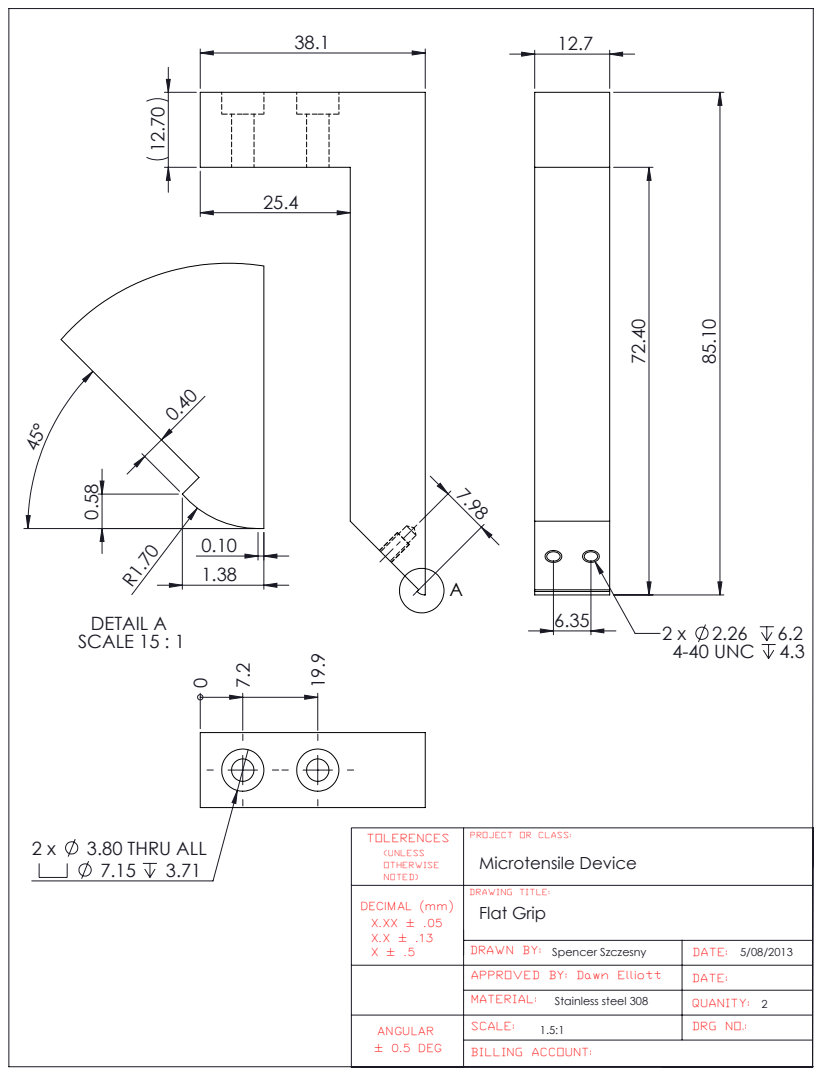
[picture p66: page 1]
2 x 2.26 6.2 4-40 UNC 4.3; 3.80 THRU ALL; DETAIL A SCALE 15 : 1; BILLING ACCOUNT:

TOLERENCES (UNLESS OTHERWISE NOTED) | PROJECT OR CLASS: Microtensile Device

DECIMAL (mm) X.XX ± .05 X.X ± .13 X ± .5 | DRAWING TITLE: Flat Grip

DRAWN BY: Spencer Szczesny | DATE: 5/08/2013
APPROVED BY: Dawn Elliott | DATE:
MATERIAL: Stainless steel 308 | QUANITY: 2

ANGULAR ± 0.5 DEG | SCALE: 1.5:1 | DRG NO.:
