Szczesnytendon/Bioreactor/Bioreactor design/Grips/Drawings/pdf/Serrated grip holder.PDF

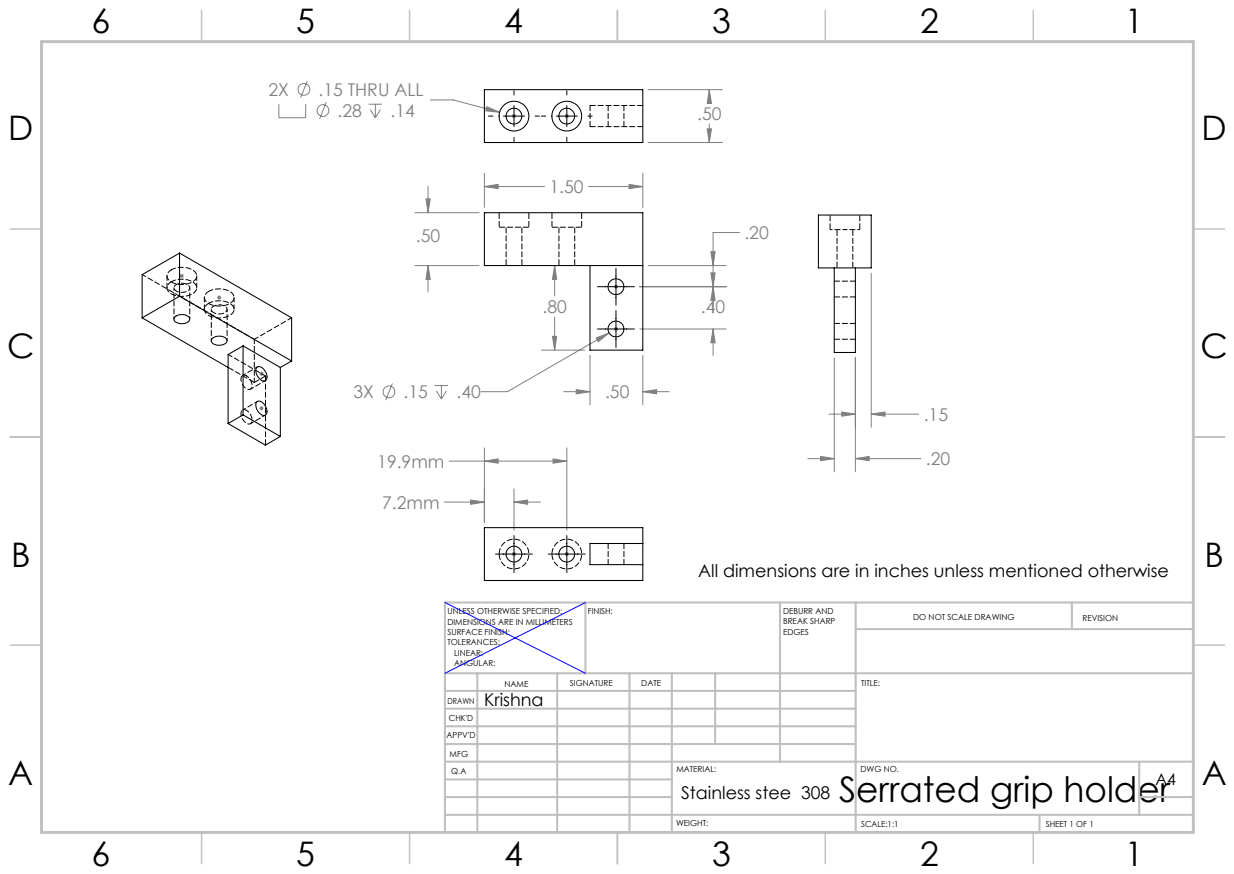
[picture p67: page 1]
.15 THRU ALL; FINISH:; DEBURR AND; BREAK SHARP; DO NOT SCALE DRAWING; REVISION; SCALE:1:1; SHEET 1 OF 1

All dimensions are in inches unless mentioned otherwise

UNLESS OTHERWISE SPECIFIED:
DIMENSIONS ARE IN MILLIMETERS
SURFACE FINISH:
TOLERANCES:
LINEAR:
ANGULAR:

NAME | SIGNATURE | DATE | | | | TITLE:
DRAWN | Krishna

CHK'D
APPV'D
MFG
Q.A | | | | MATERIAL: Serrated grip holder Stainless stee 308 | DWG NO. | A4
