Szczesnytendon/Bioreactor/Bioreactor design/Grips/Drawings/pdf/Serrated grip right.PDF

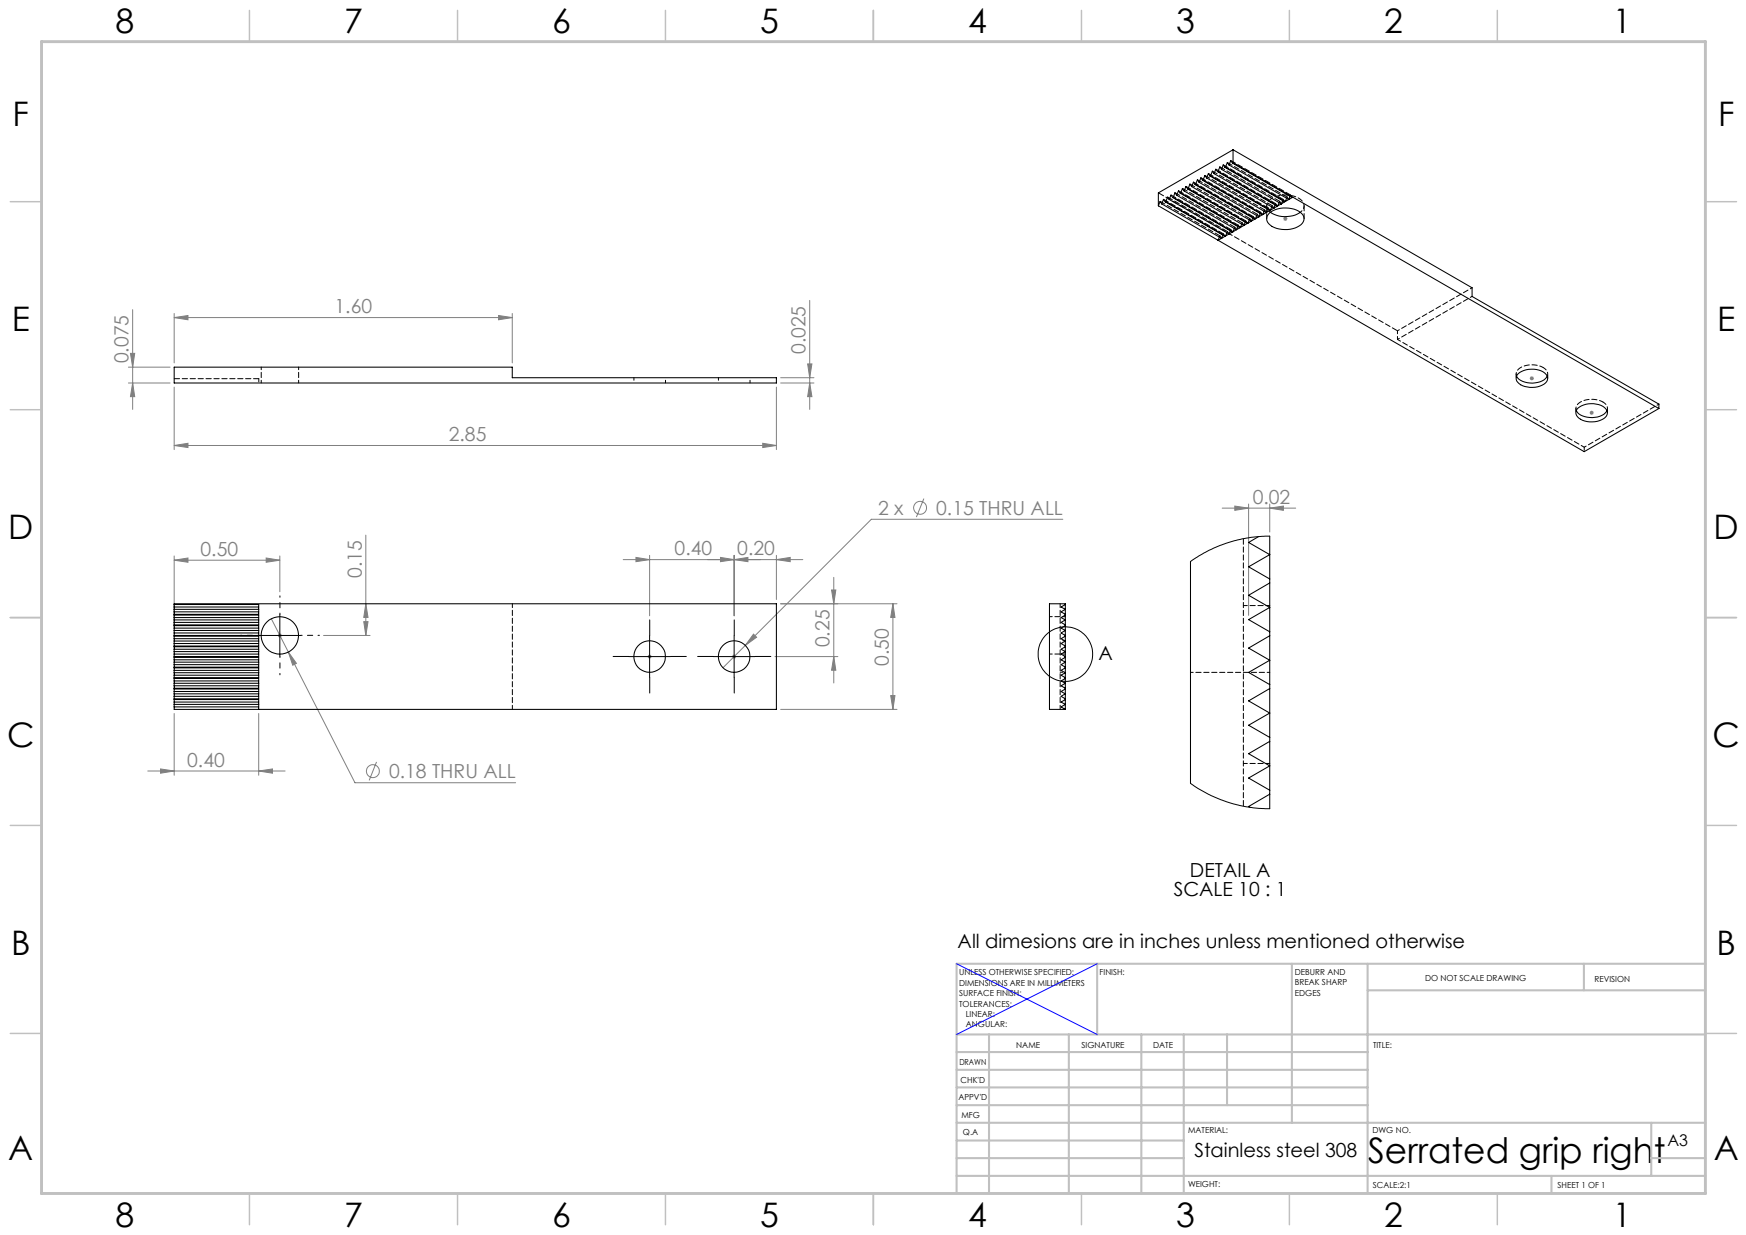
[picture p68: page 1]
0.18 THRU ALL; 0.15 THRU ALL; DETAIL A SCALE 10 : 1; Stainless steel 308; FINISH:; DEBURR AND; BREAK SHARP; DO NOT SCALE DRAWING; REVISION; SCALE:2:1; SHEET 1 OF 1

All dimesions are in inches unless mentioned otherwise

UNLESS OTHERWISE SPECIFIED:
DIMENSIONS ARE IN MILLIMETERS
SURFACE FINISH:
TOLERANCES:
LINEAR:
ANGULAR:

NAME | SIGNATURE | DATE | | | | TITLE:

DRAWN
CHK'D
APPV'D
MFG
Q.A | | | | MATERIAL: | DWG NO. Serrated grip right | A3
